tr0fin0/dolphin/README.md

# dolphin
Firmware for `dolphin` board, an ESP32-S3 based sumo robot controller.
