tr0fin0/dolphin/docs/source/hardware/index.rst

Hardware
========

.. toctree::
    :maxdepth: 2
    :caption: Table of Contents

    architecture/index
    encoder/index
    line/index
    mainboard/index
