tr0fin0/dolphin/docs/source/hardware/encoder/files/index.rst

Files
=====

.. toctree::
    :maxdepth: 2
    :caption: Table of Contents

    bom/index
    pcb/index
    sch/index
