tr0fin0/dolphin/docs/source/hardware/encoder/files/pcb/index.rst

PCB
===

.. tab-set::

    .. tab-item:: Bottom

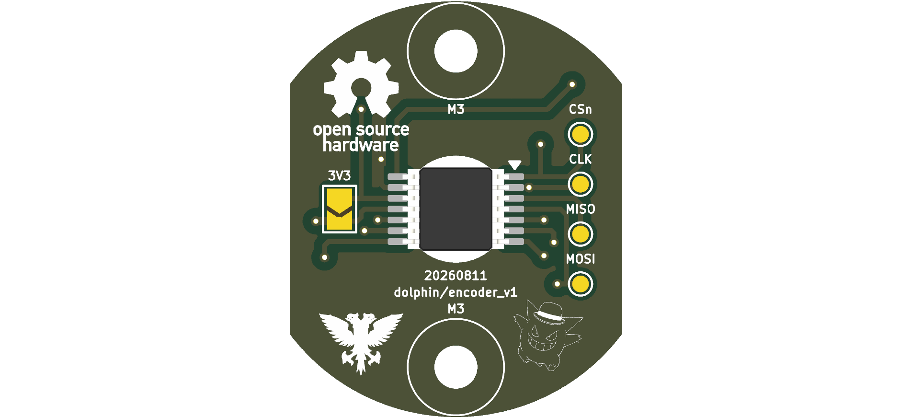
[picture p1: hardware/projects/encoder/images/encoder_bottom.png]
PCB Bottom View
        

    .. tab-item:: Top

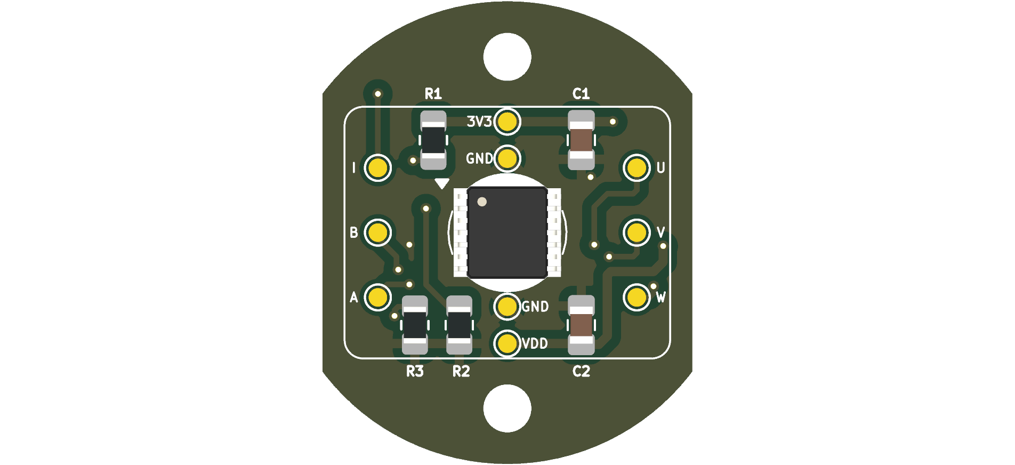
[picture p2: hardware/projects/encoder/images/encoder_top.png]
PCB Top View
