tr0fin0/dolphin/docs/source/hardware/encoder/files/sch/index.rst

SCH
===

.. pdf-include:: ../../../../../../../hardware/projects/encoder/encoder.pdf
