tr0fin0/dolphin/docs/source/hardware/line/files/pcb/index.rst

PCB
===

.. tab-set::

    .. tab-item:: Bottom

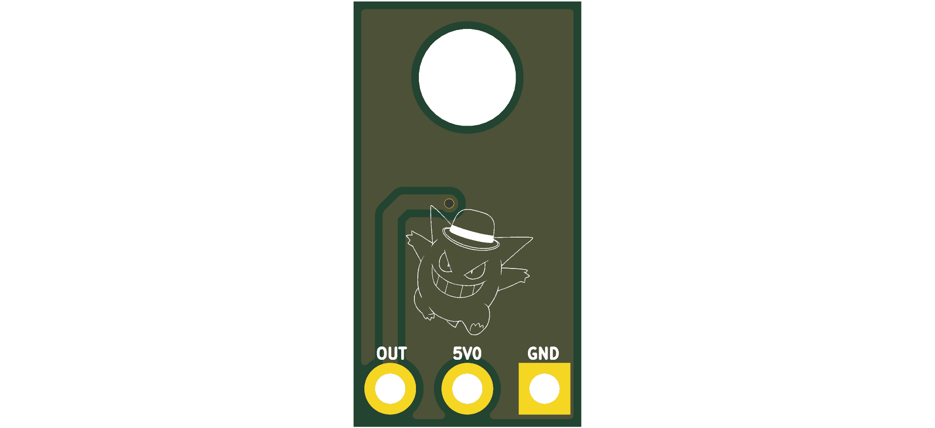
[picture p3: hardware/projects/line/images/line_bottom.png]
PCB Bottom View
        

    .. tab-item:: Top

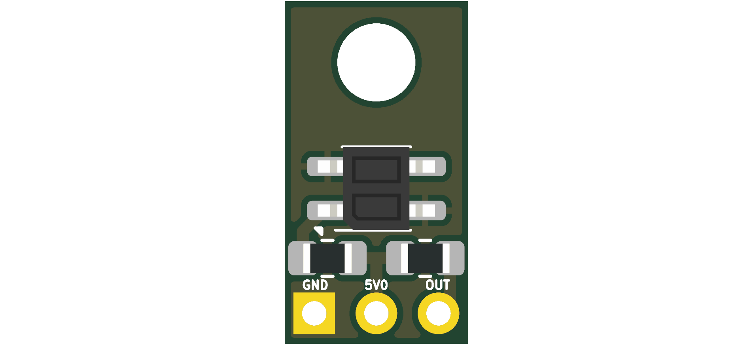
[picture p4: hardware/projects/line/images/line_top.png]
PCB Top View
