tr0fin0/dolphin/docs/source/hardware/mainboard/files/pcb/index.rst

PCB
===

.. tab-set::

    .. tab-item:: Bottom

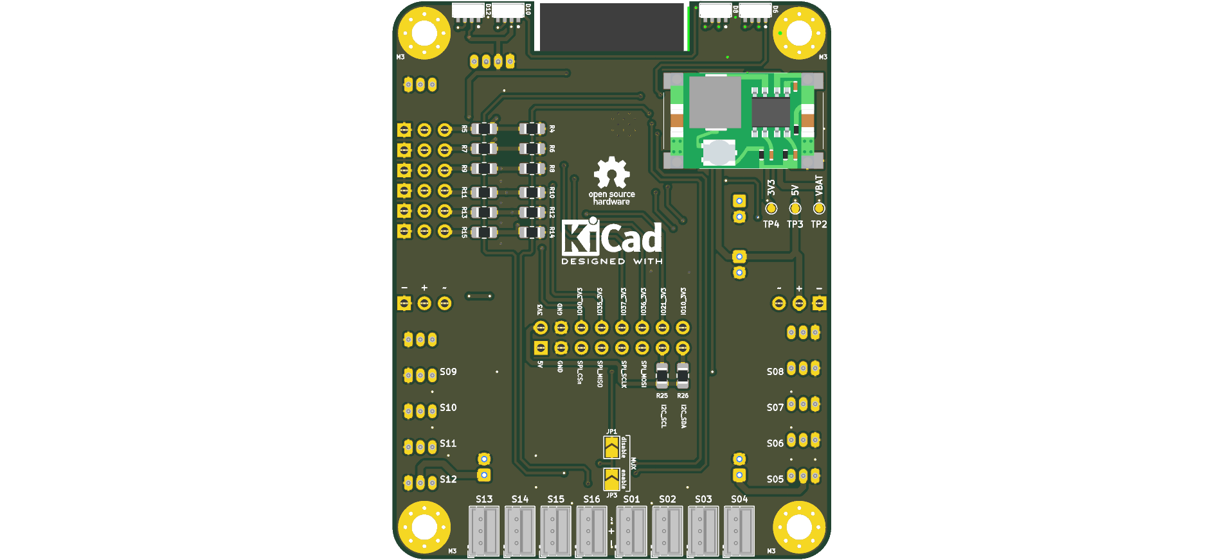
[picture p5: hardware/projects/mainboard/images/mainboard_bottom.png]
PCB Bottom View
        

    .. tab-item:: Top

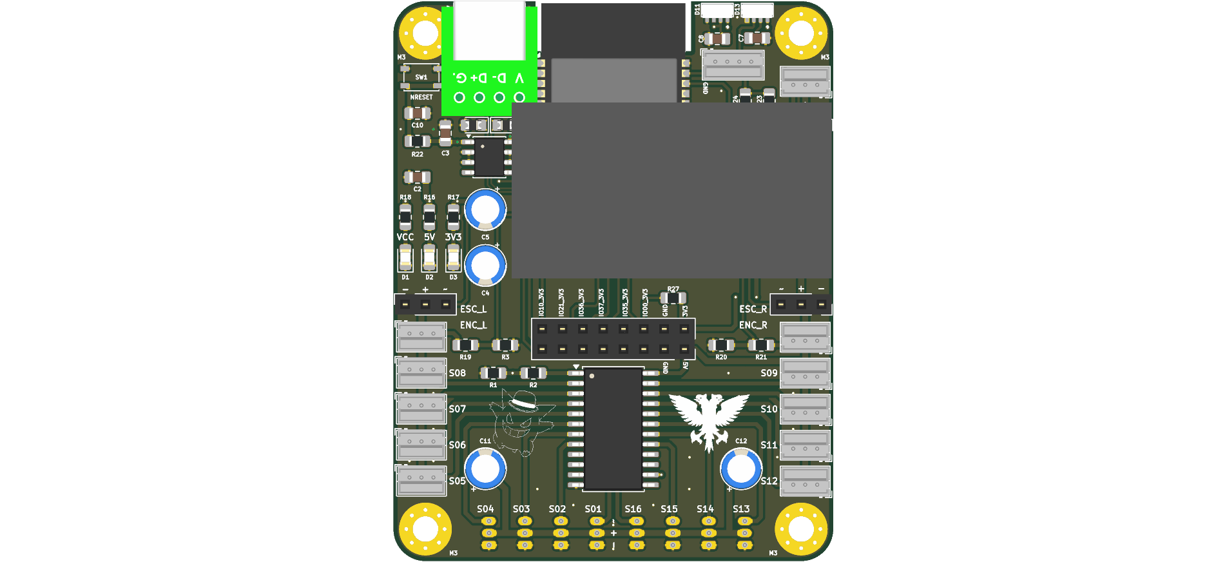
[picture p6: hardware/projects/mainboard/images/mainboard_top.png]
PCB Top View
