tr0fin0/dolphin/docs/source/hardware/encoder/files/bom/index.rst

BOM
===

.. csv-table::
    :file: ../../../../../../hardware/projects/encoder/encoder.csv
    :header-rows: 1
