tr0fin0/dolphin/docs/source/hardware/line/files/bom/index.rst

BOM
===

.. csv-table::
    :file: ../../../../../../hardware/projects/line/line.csv
    :header-rows: 1
