tr0fin0/dolphin/docs/source/hardware/mainboard/files/bom/index.rst

BOM
===

.. csv-table::
    :file: ../../../../../../hardware/projects/mainboard/mainboard.csv
    :header-rows: 1
