tr0fin0/dolphin/hardware/projects/mainboard/mainboard.step

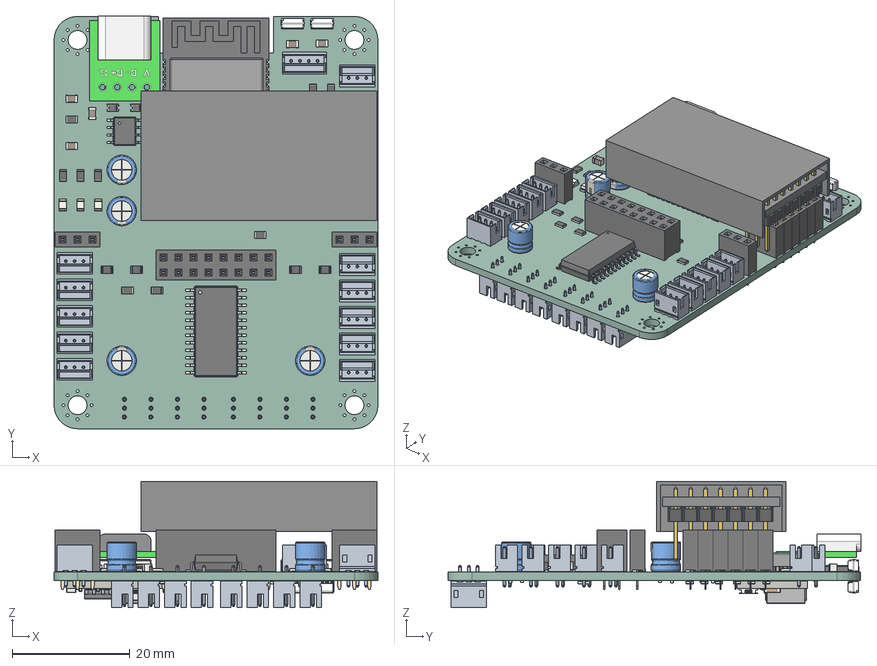
[picture p7: CAD file, 2026-08-26]
hardware/projects/mainboard/mainboard.step
55.0 x 70.0 x 21.5 mm
R_0805_2012Metric x 27
WS2812B-4020 x 8
x1502wv-04k-n0sn
D_0805 x 2
CP_Radial_D50mm_P200mm x 4
C_0805_2012Metric x 8
x1502wv-03k-n0sn x 19
PinSocket_2x08_P254mm_Vertical
LED_0805_2012Metric x 3
SOIC_24W_75x154mm_P127mm
729b06ae-9266-11ed-9e62-a0cec80452fd_part
729b0bae-9266-11ed-9e62-a0cec80452fd_part
729b0e92-9266-11ed-9e62-a0cec80452fd_part
729b1108-9266-11ed-9e62-a0cec80452fd_part
USB-C connector
ESP32-S3-WROOM-1
PinSocket_1x03_P254mm_Vertical x 8
Flysky FS-iA6 Receiver Body
3x7 Header
(Unsaved)
mainboard_PCB
