tr0fin0/dolphin/hardware/projects/encoder/encoder.step

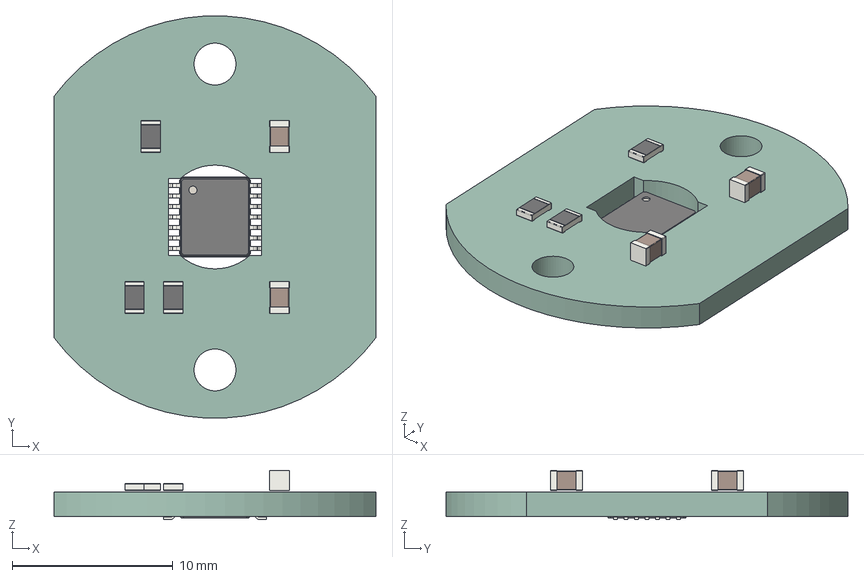
[picture p8: CAD file, 2026-08-26]
hardware/projects/encoder/encoder.step
20.0 x 25.0 x 3.05 mm
C_0805_2012Metric x 2
R_0805_2012Metric x 3
TSSOP_14_44x5mm_P065mm
encoder_PCB
