tr0fin0/dolphin/hardware/projects/line/line.step

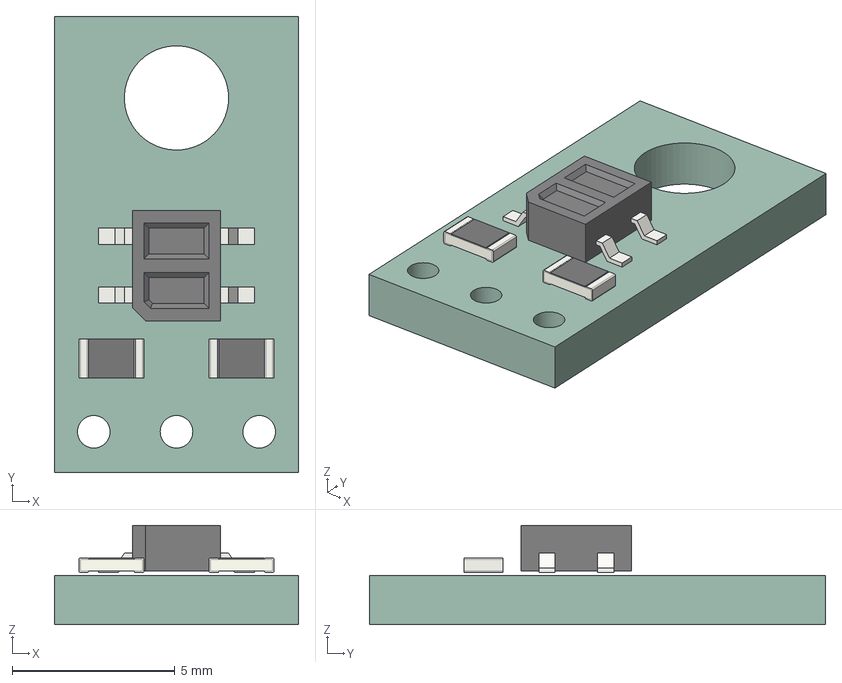
[picture p9: CAD file, 2026-08-26]
hardware/projects/line/line.step
7.50 x 14.0 x 3.04 mm
R_0805_2012Metric x 2
OnSemi_CASE100CY
line_PCB
