tr0fin0/dolphin/docs/source/installation/index.rst

Installation
============

.. toctree::
   :maxdepth: 2
   :caption: Table of Contents

   kicad/index
   platformio/index
