tr0fin0/dolphin/docs/source/installation/kicad/index.rst

KiCAD
=====

After `installing KiCAD <https://www.kicad.org/download/>`_ make sure that the Footprint and Symbol libraries are correctly referenced in the project.

.. toctree::
   :maxdepth: 2
   :caption: Table of Contents

   how-to/index
