tr0fin0/dolphin/docs/source/installation/kicad/how-to/index.rst

How To...
=========

.. toctree::
   :maxdepth: 2

   footprint/index
   symbol/index
