tr0fin0/dolphin/.github/ISSUES_TEMPLATE/bug.md

---
name: bug
about: Issue reporting a code bug.
title: ''
labels: ''
assignees: ''

---

**Description**
A clear and concise description of what the bug is.

**To Reproduce**
Steps to reproduce the behavior:
1.

**Expected Behavior**
A clear and concise description of what you expected to happen.

**Platform**
 - OS: [e.g. Ubuntu 24.04 LTS]
 - IDE: [e.g. VSCode]
 - TeX Live version: [e.g. 2025]

**Additional Information**
Add any other context about the problem.
