tr0fin0/dolphin/hardware/projects/encoder/encoder.pdf

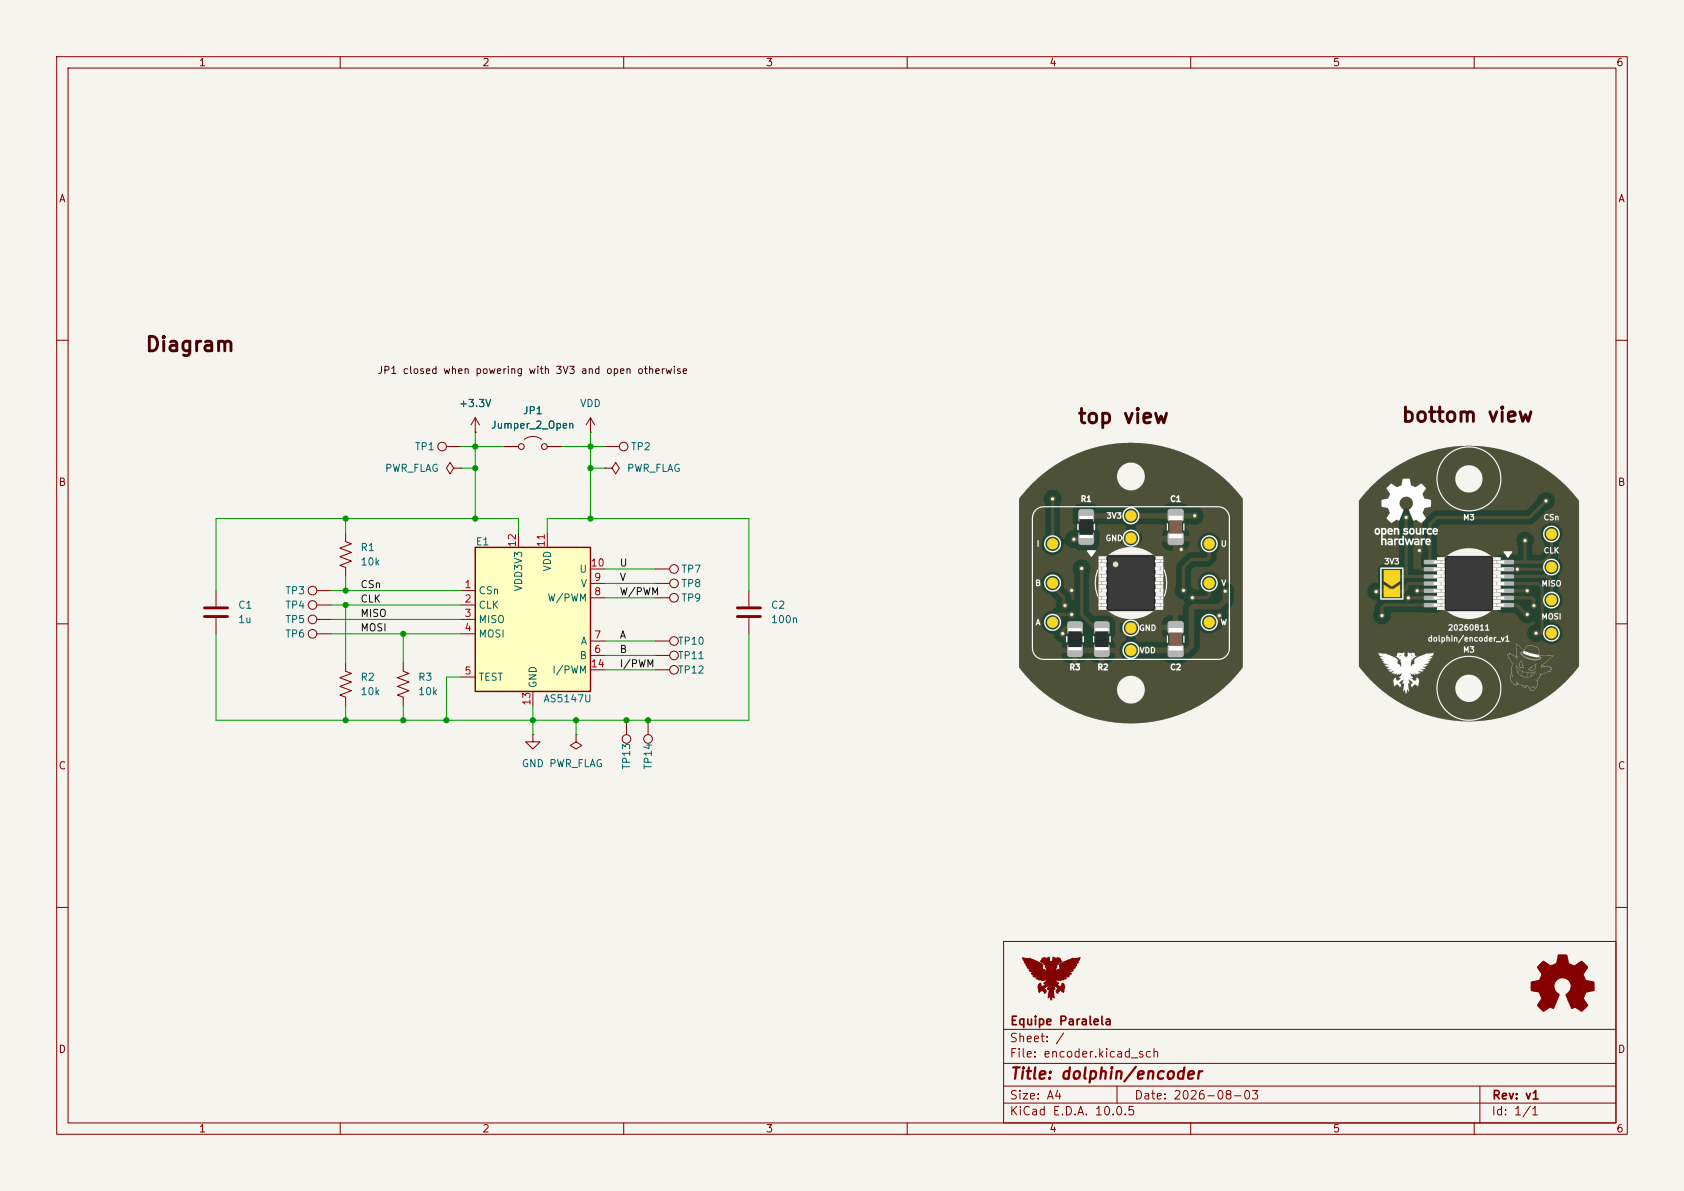
[picture p10: page 1]

JP1 closed when powering with 3V3 and open otherwise Diagram

Size: A4 | Rev: v1
KiCad E.D.A. 10.0.5 | Id: 1/1
