tr0fin0/dolphin/hardware/projects/line/line.pdf

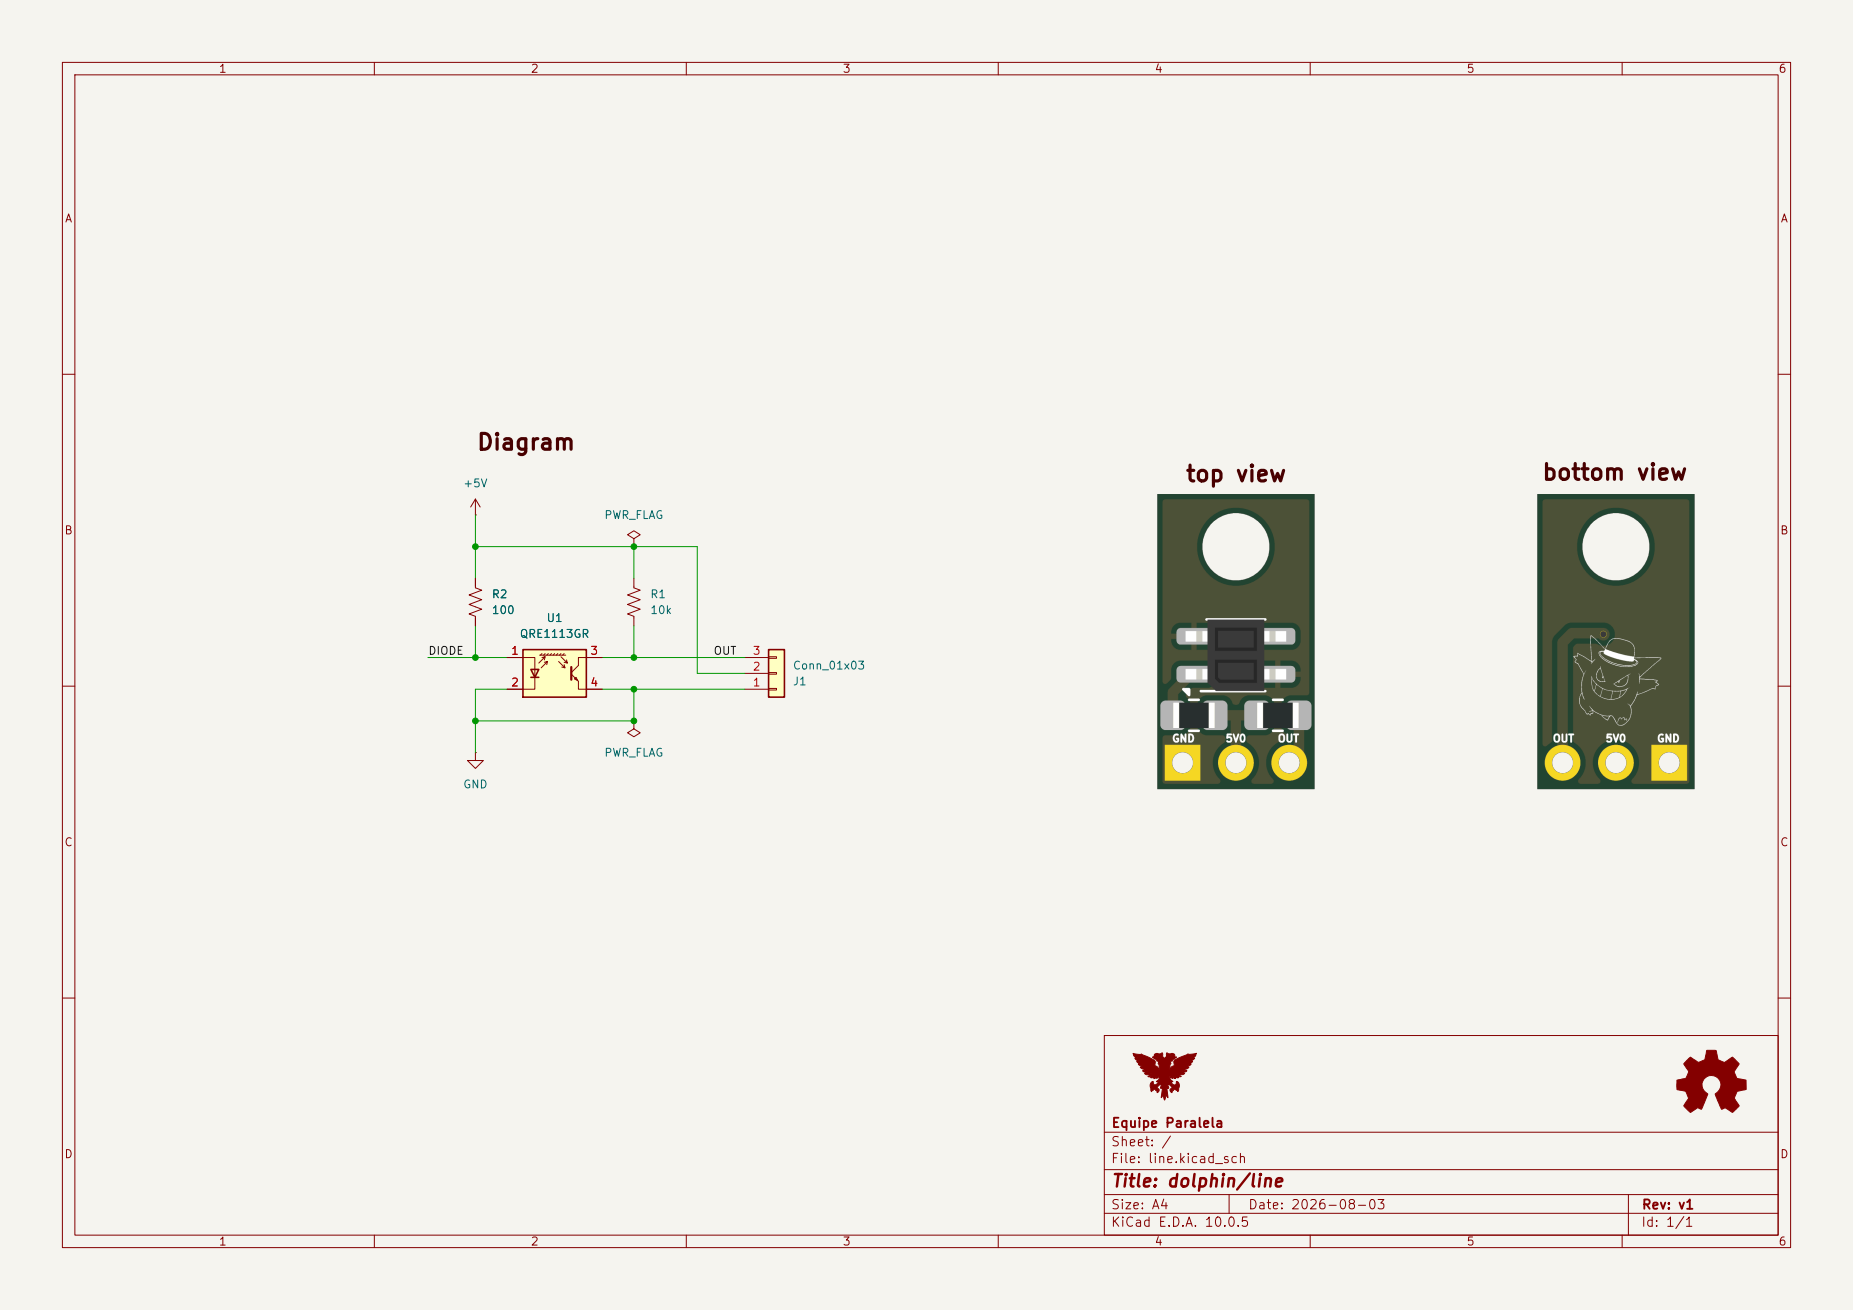
[picture p11: page 1]

Size: A4 | Rev: v1
KiCad E.D.A. 10.0.5 | Id: 1/1
