tr0fin0/dolphin/hardware/projects/mainboard/mainboard.pdf

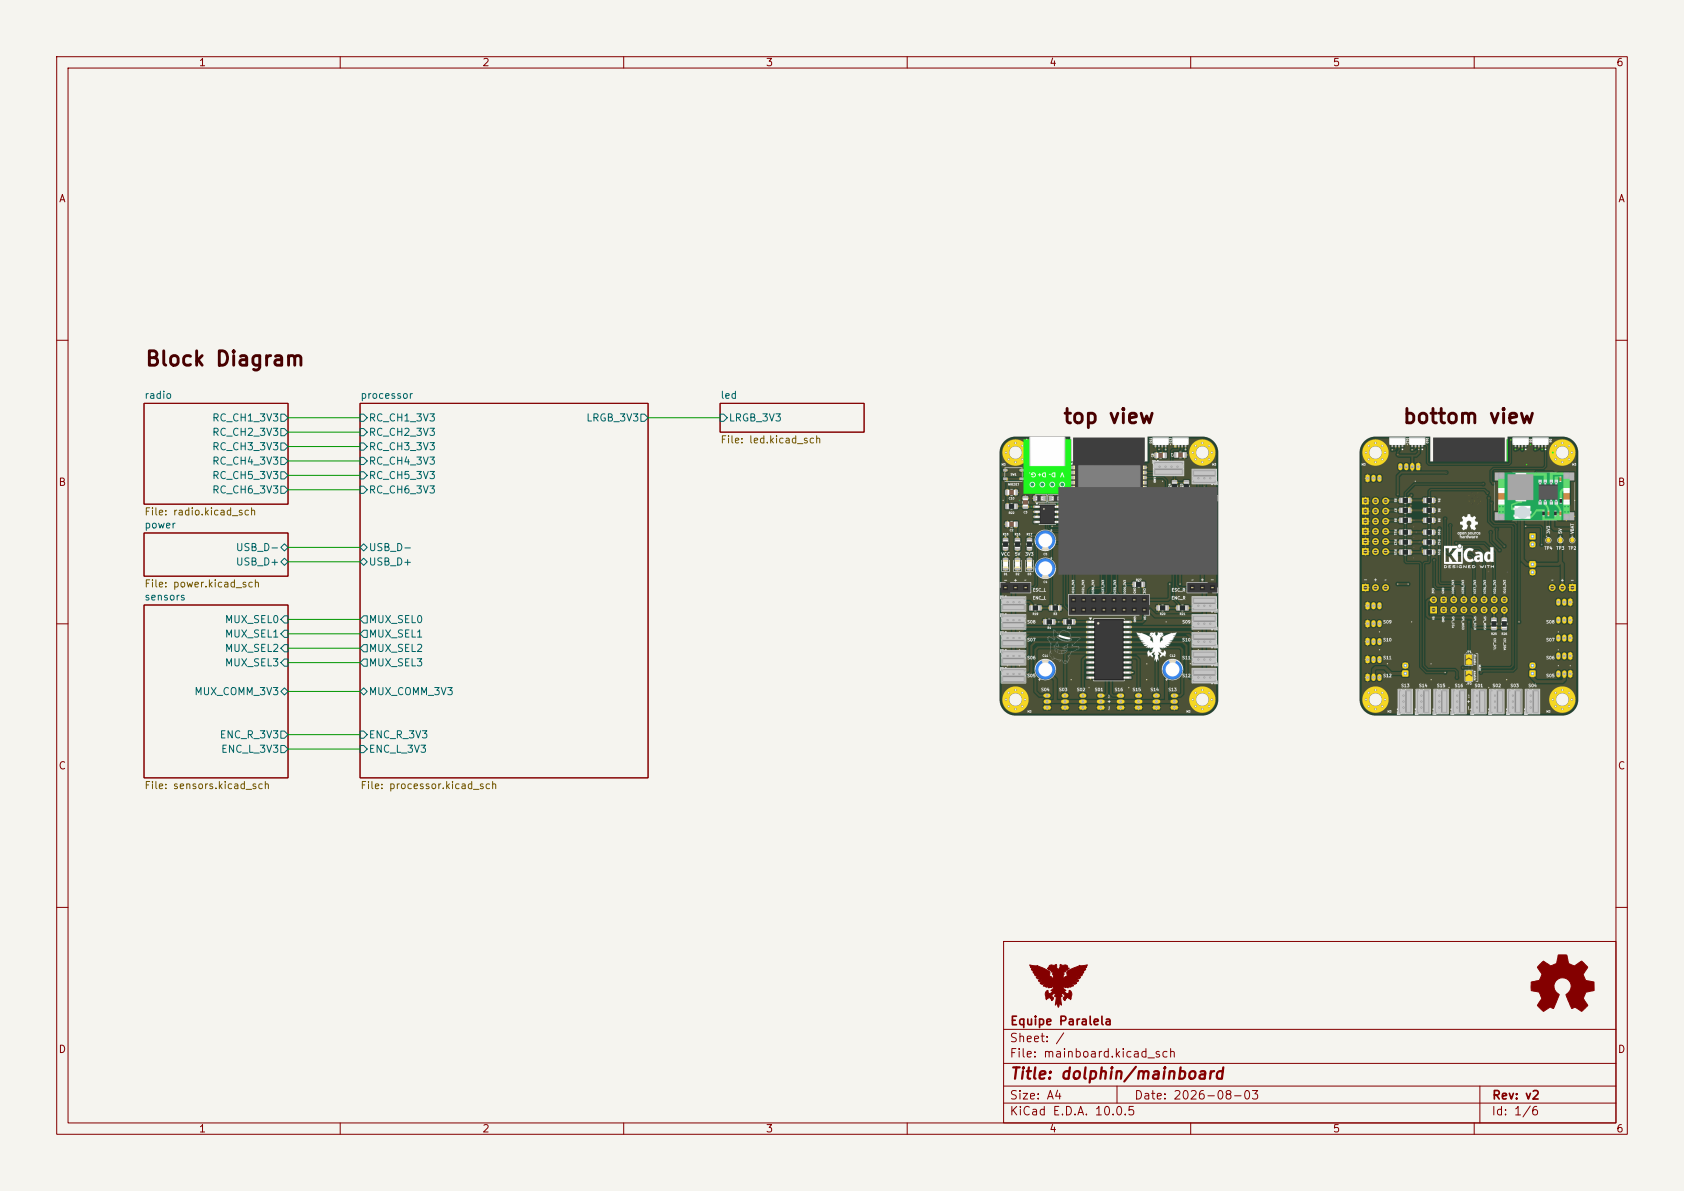
[picture p12: page 1]

Size: A4 | Rev: v2
KiCad E.D.A. 10.0.5 | Id: 1/6

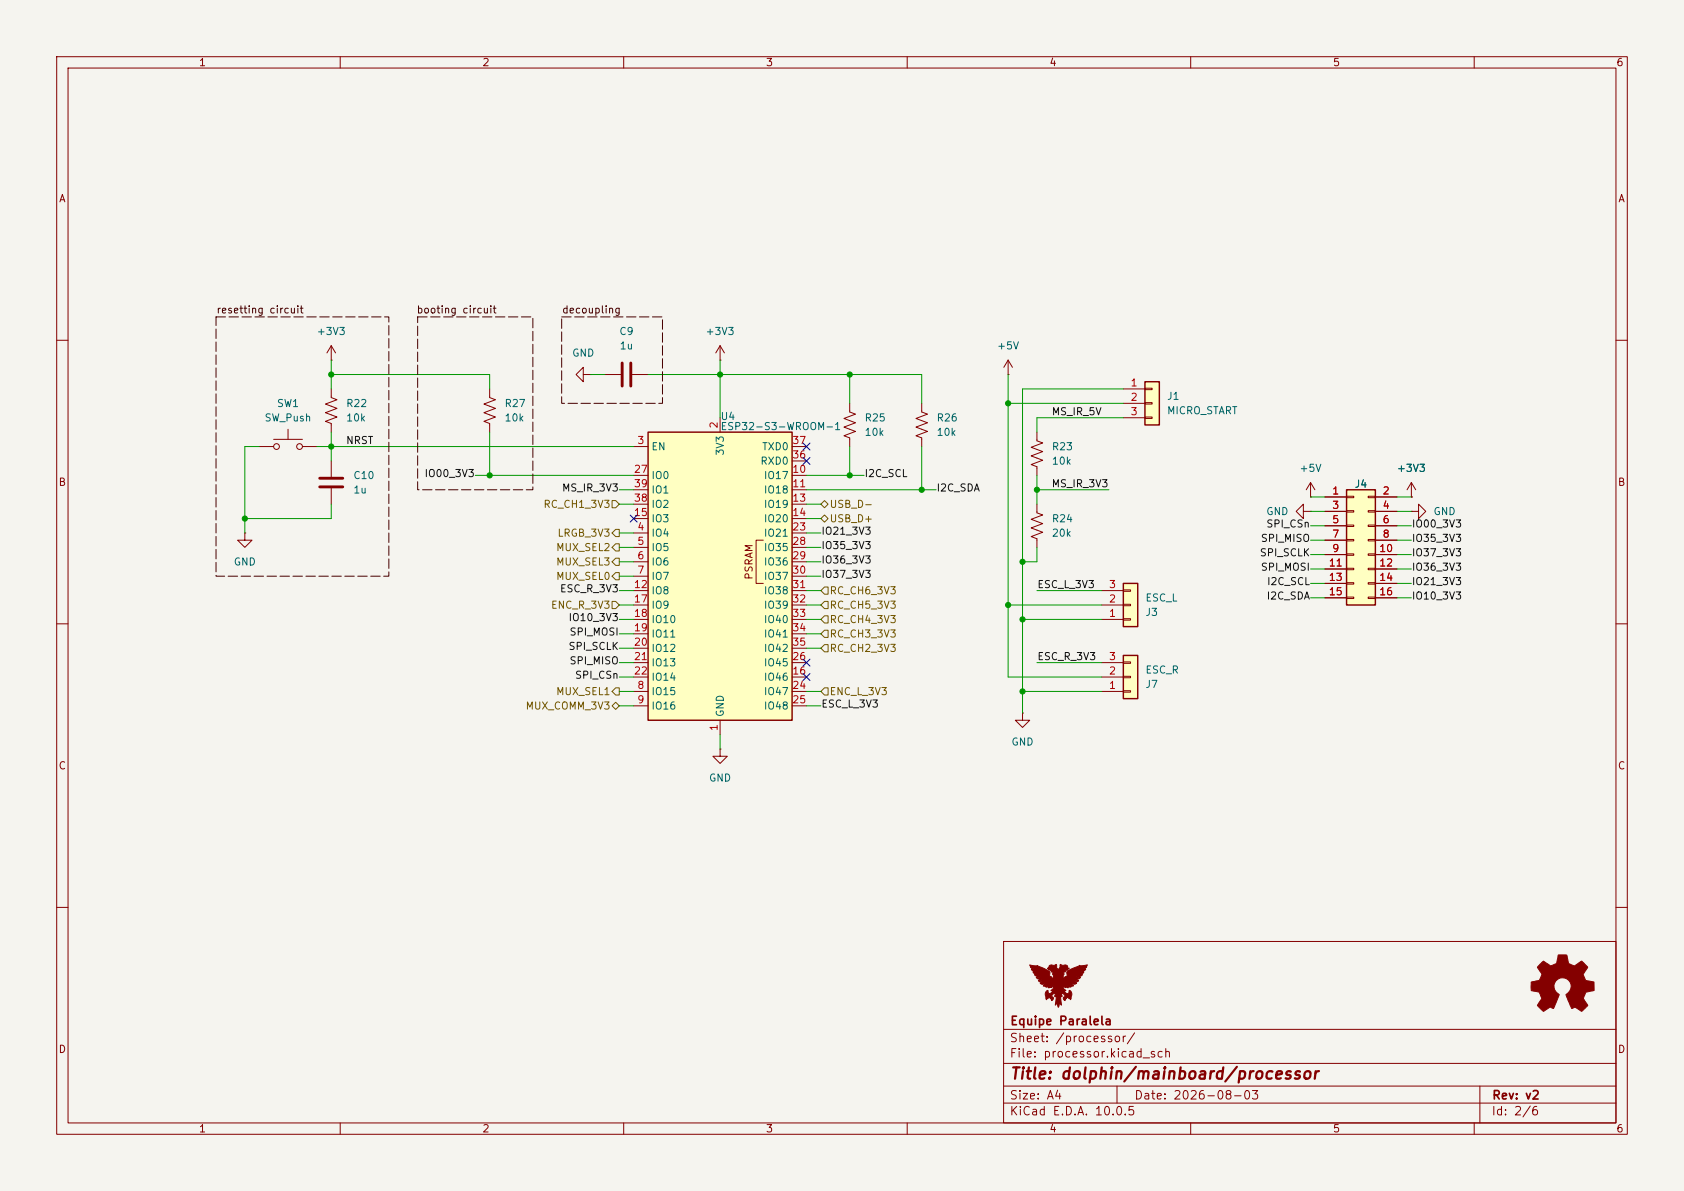
[picture p13: page 2]

Equipe Paralela
Sheet: /processor/
File: processor.kicad_sch
Title: dolphin/mainboard/processor

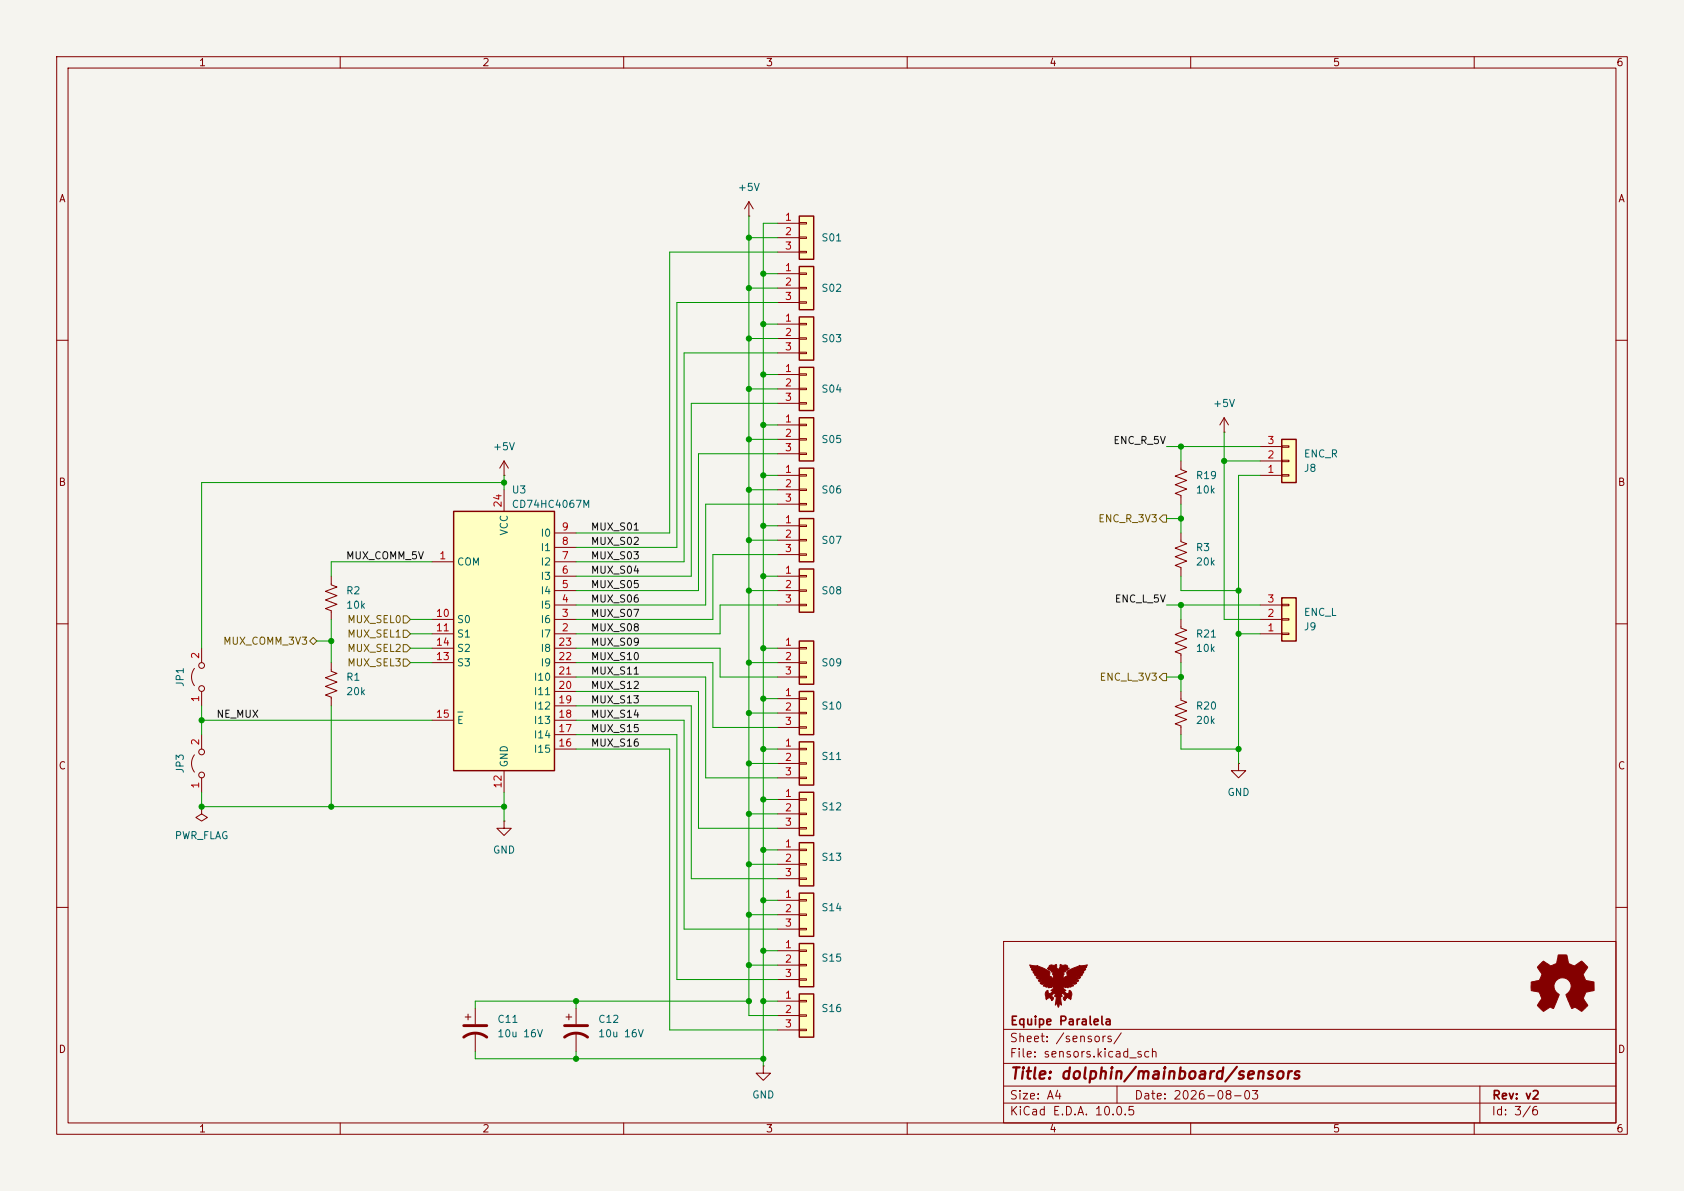
[picture p14: page 3]

Equipe Paralela
Sheet: /sensors/
File: sensors.kicad_sch
Title: dolphin/mainboard/sensors

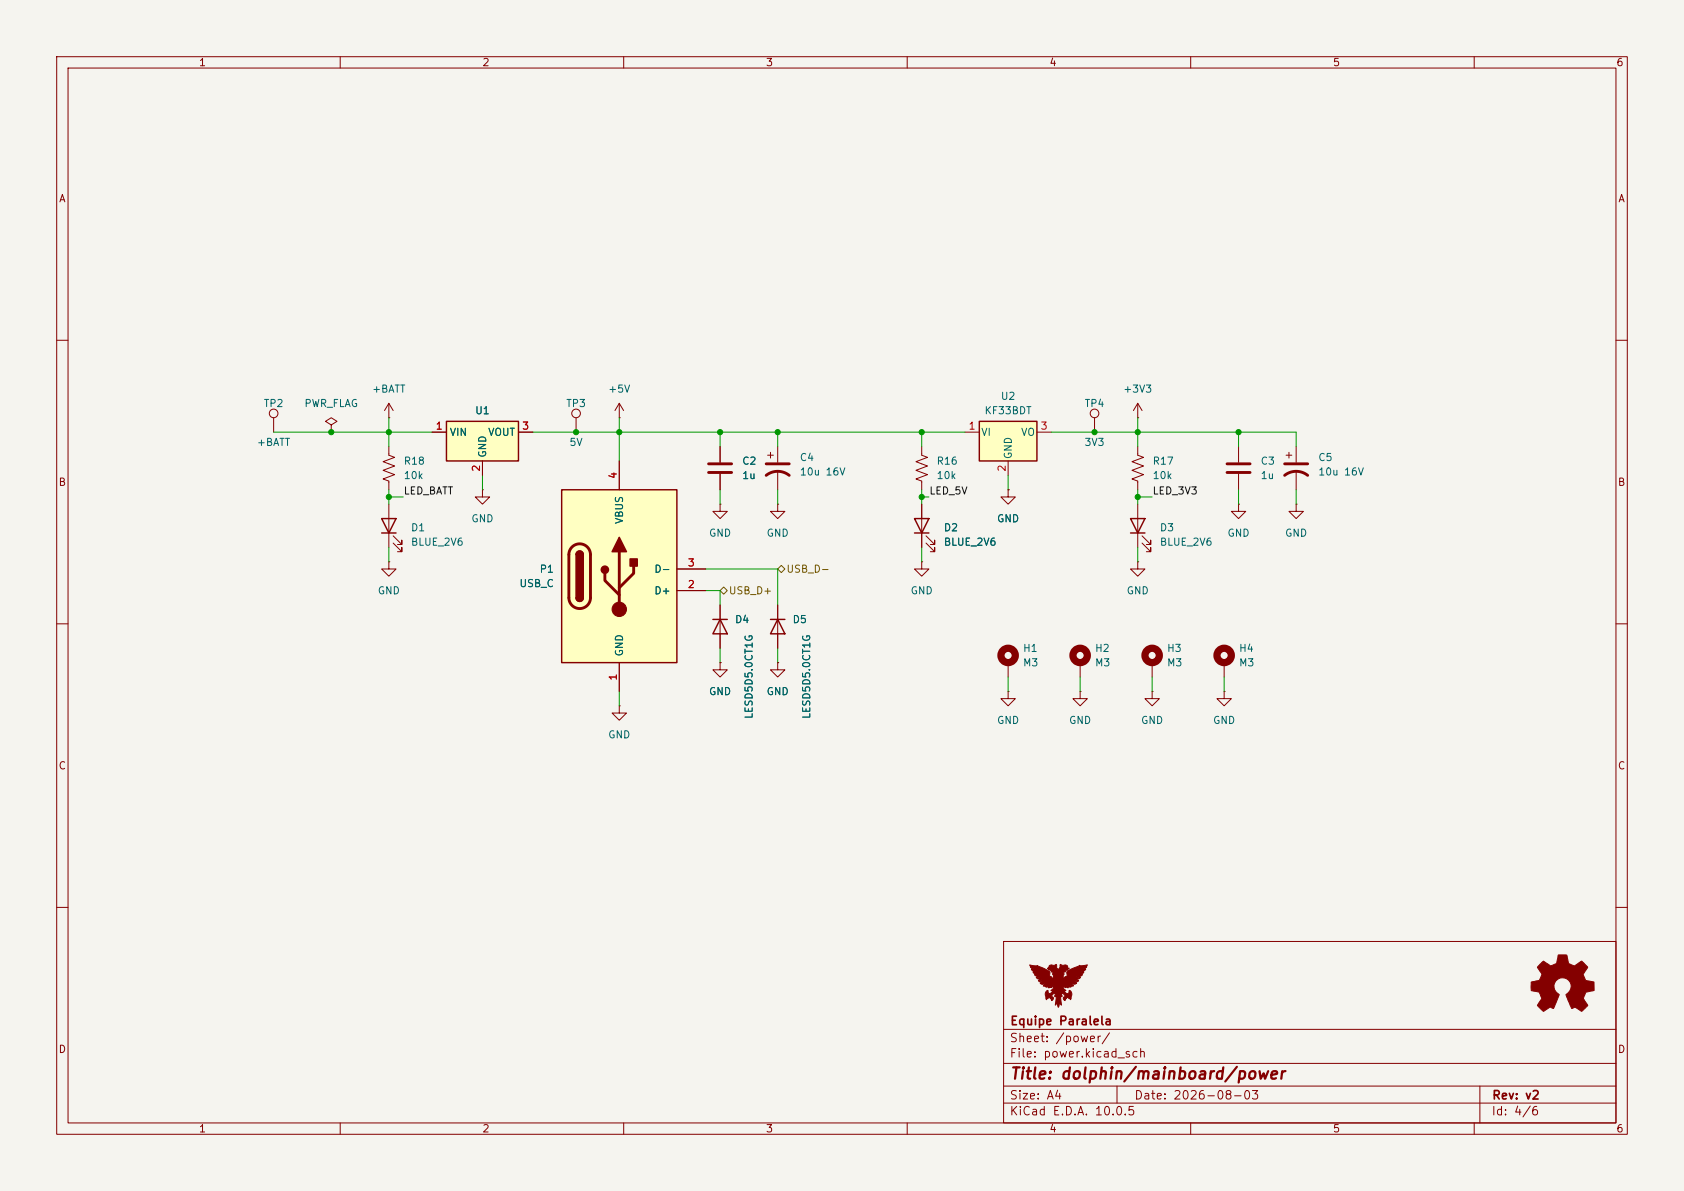
[picture p15: page 4]

Equipe Paralela
Sheet: /power/
File: power.kicad_sch
Title: dolphin/mainboard/power

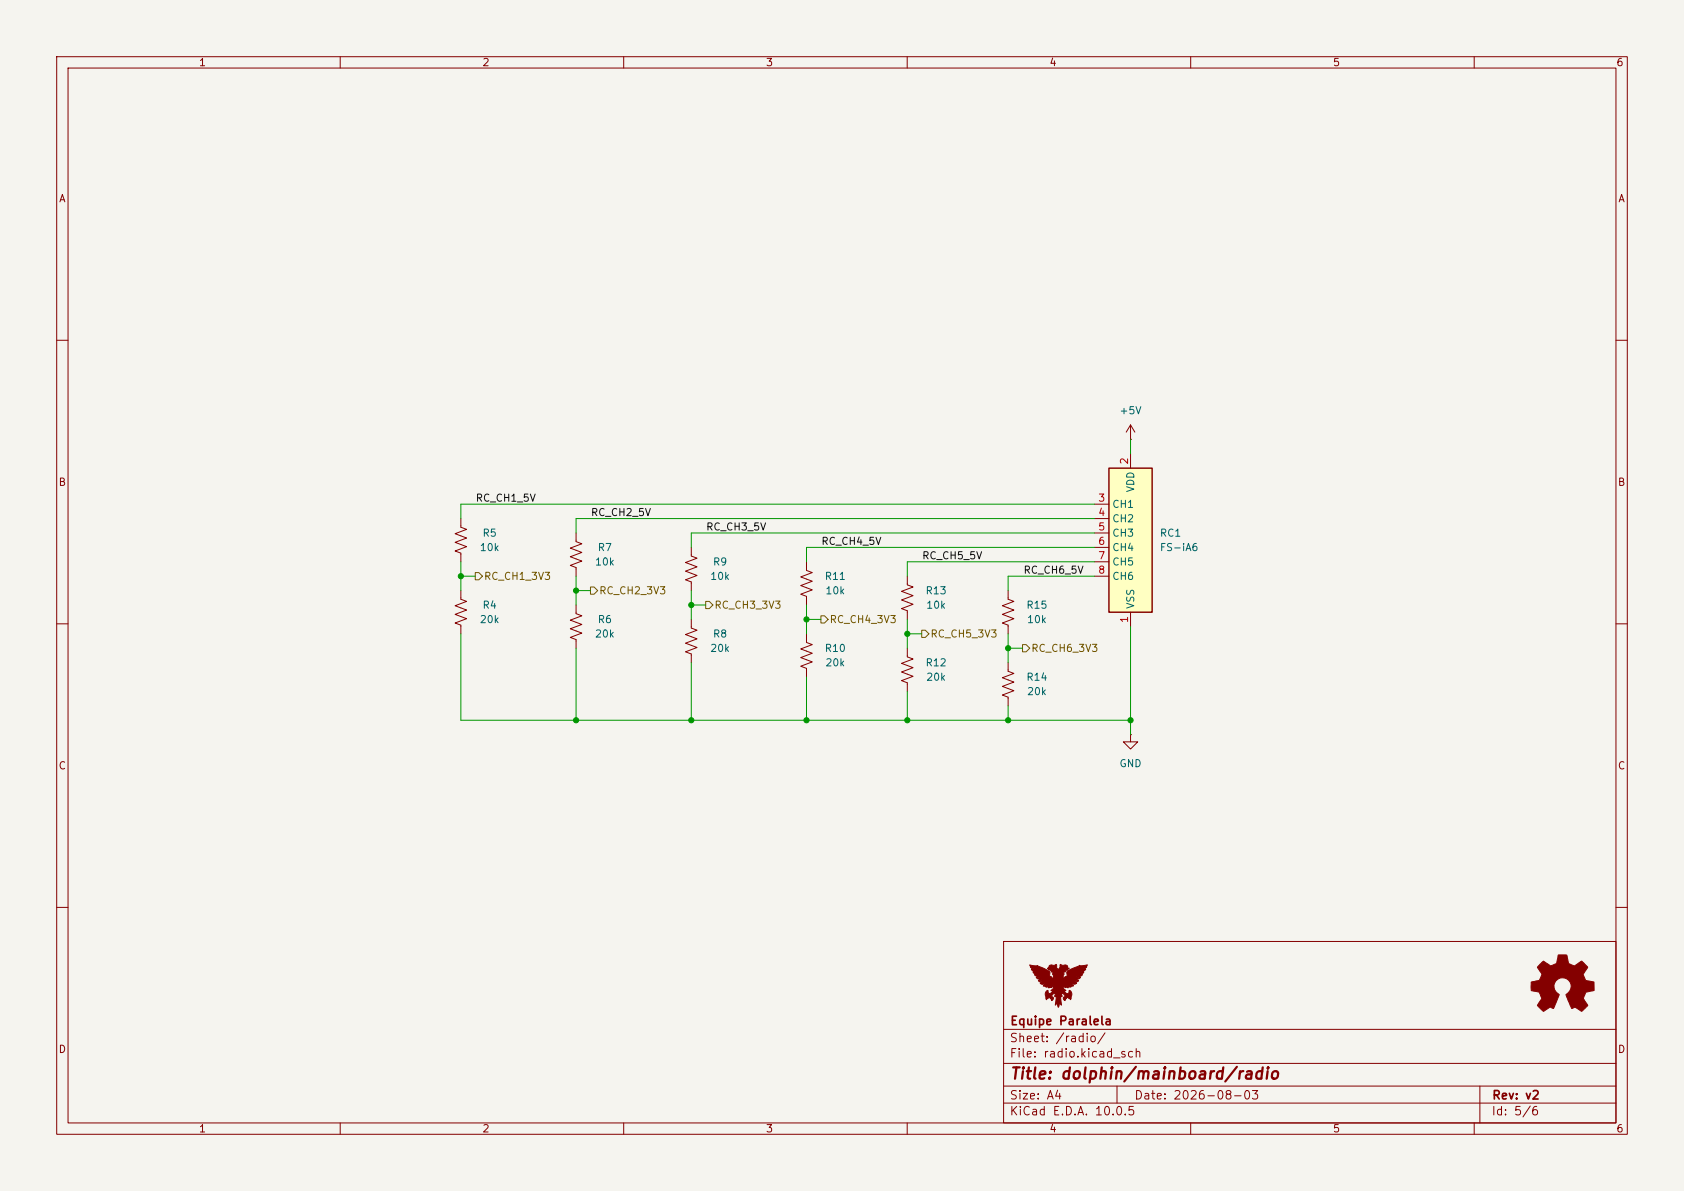
[picture p16: page 5]

Equipe Paralela
Sheet: /radio/
File: radio.kicad_sch
Title: dolphin/mainboard/radio

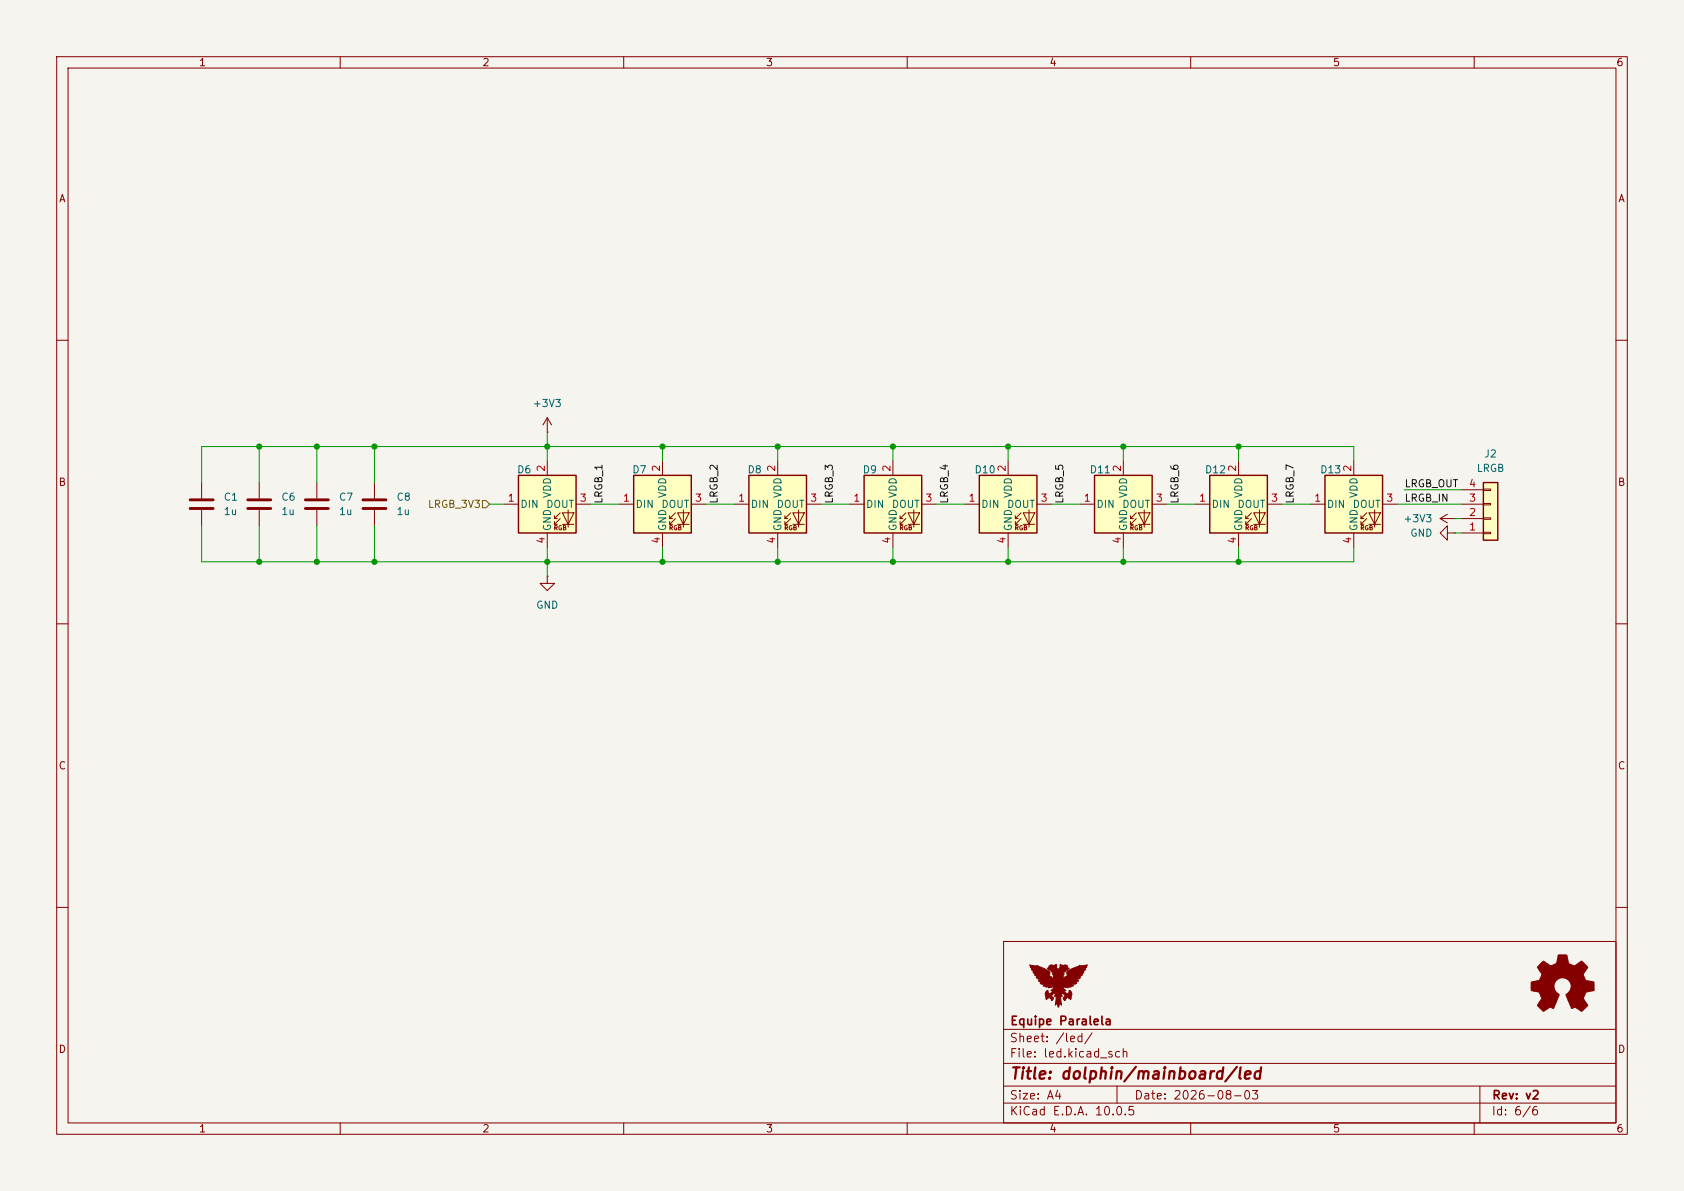
[picture p17: page 6]

Equipe Paralela
Sheet: /led/
File: led.kicad_sch
Title: dolphin/mainboard/led
