tr0fin0/dolphin/hardware/projects/mainboard/mainboard.kicad_pcb

## KiCad design hardware/projects/mainboard/mainboard.kicad_pcb (2026-08-26)

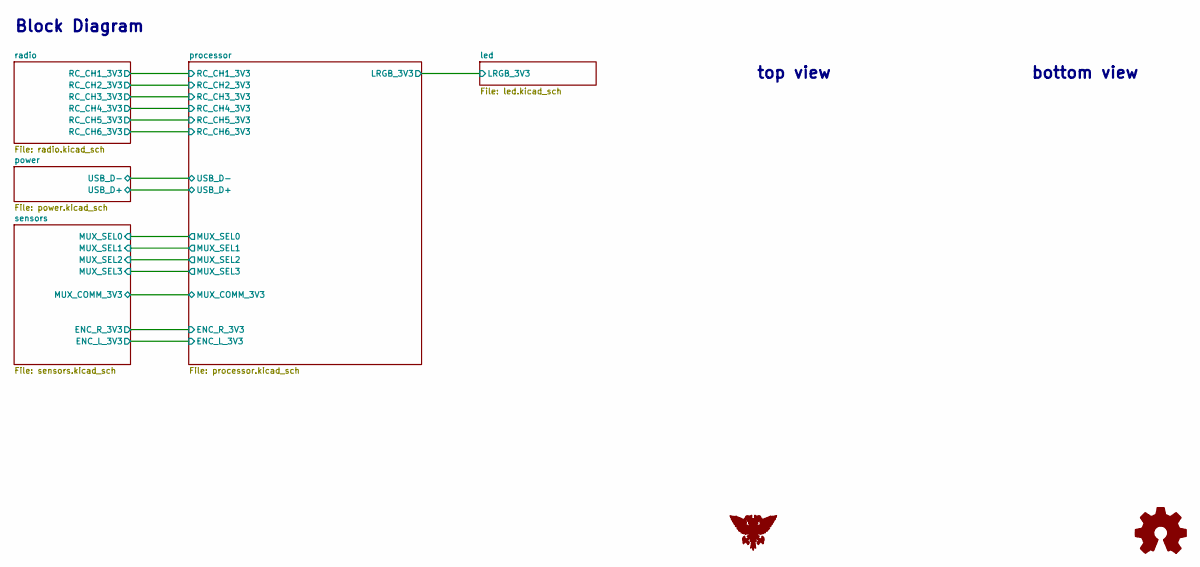
[picture p18: schematic mainboard.kicad_sch]

Notes on the sheet:
top view
bottom view
Block Diagram

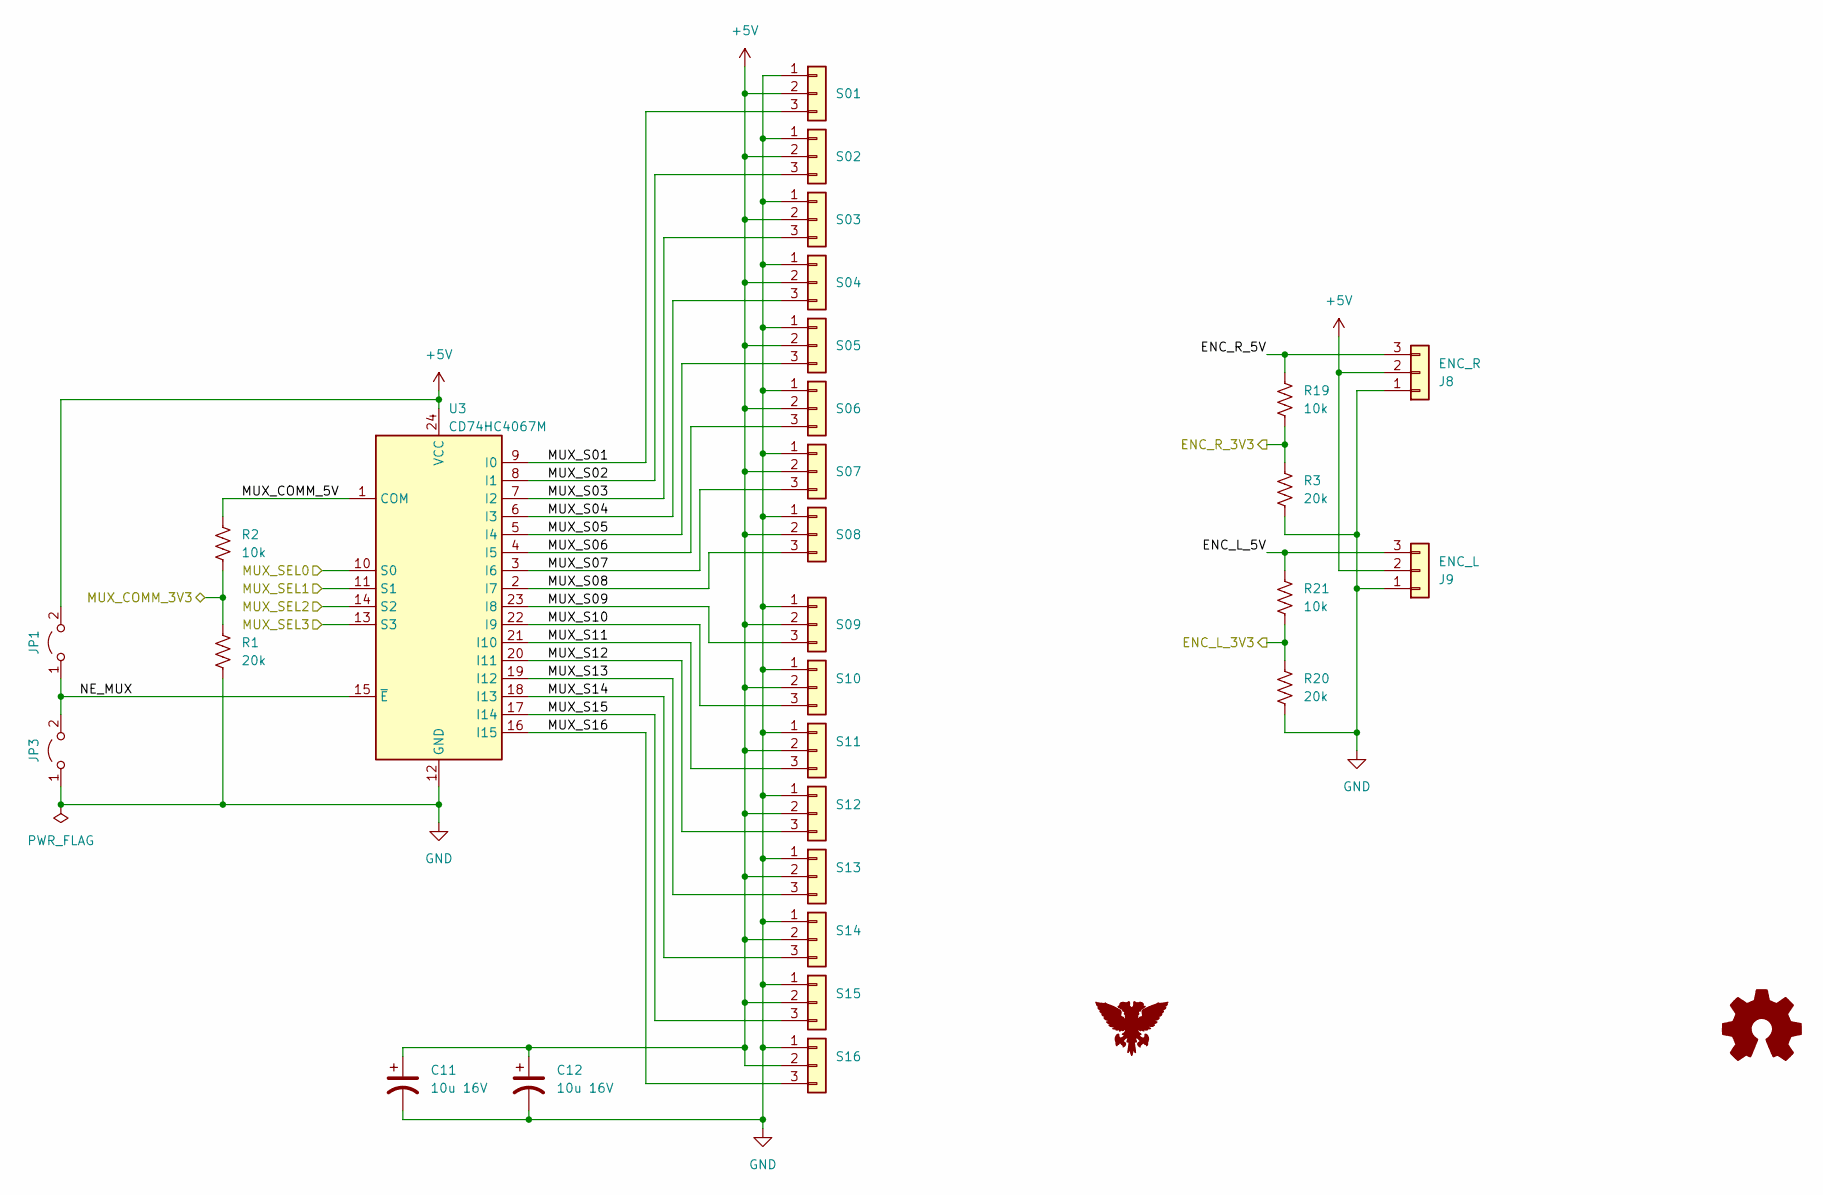
[picture p19: schematic sensors.kicad_sch]

Parts:
C11, C12: 10u 16V; CP_Radial_D5.0mm_P2.00mm
J8: ENC_R; Connector_JST_ZH_B3B-ZR_1x03_P1.50mm_Vertical
J9: ENC_L; Connector_JST_ZH_B3B-ZR_1x03_P1.50mm_Vertical
JP1, JP3: Jumper_2_Open; SolderJumper-2_P1.3mm_Open_TrianglePad1.0x1.5mm
R1, R3, R20: 20k; R_0805_2012Metric_Pad1.20x1.40mm_HandSolder
R2, R19, R21: 10k; R_0805_2012Metric_Pad1.20x1.40mm_HandSolder
S01, S02, S03, S04, S05, S06, S07, S08, S09, S10, S11, S12, S13, S14, S15, S16: Conn_01x03; Connector_JST_ZH_B3B-ZR_1x03_P1.50mm_Vertical
U3: CD74HC4067M; SOIC-24W_7.5x15.4mm_P1.27mm

Connections:
+5V: C11.1, C12.1, J8.2, J9.2, JP1.2 (B), S01.2, S02.2, S03.2, S04.2, S05.2, S06.2, S07.2, S08.2, S09.2, S10.2, S11.2, S12.2, S13.2, S14.2, S15.2, S16.2, U3.24 (VCC); also elsewhere on the board
/processor/ENC_L_3V3: R20.1, R21.1; also elsewhere on the board
/processor/ENC_R_3V3: R3.1, R19.1; also elsewhere on the board
/processor/MUX_COMM_3V3: R1.1, R2.1; also elsewhere on the board
/processor/MUX_SEL0: U3.10 (S0); also elsewhere on the board
/processor/MUX_SEL1: U3.11 (S1); also elsewhere on the board
/processor/MUX_SEL2: U3.14 (S2); also elsewhere on the board
/processor/MUX_SEL3: U3.13 (S3); also elsewhere on the board
/sensors/ENC_L_5V: J9.3, R21.2
/sensors/ENC_R_5V: J8.3, R19.2
/sensors/MUX_COMM_5V: R2.2, U3.1 (COM)
/sensors/MUX_S01: S01.3, U3.9 (I0)
/sensors/MUX_S02: S02.3, U3.8 (I1)
/sensors/MUX_S03: S03.3, U3.7 (I2)
/sensors/MUX_S04: S04.3, U3.6 (I3)
/sensors/MUX_S05: S05.3, U3.5 (I4)
/sensors/MUX_S06: S06.3, U3.4 (I5)
/sensors/MUX_S07: S07.3, U3.3 (I6)
/sensors/MUX_S08: S08.3, U3.2 (I7)
/sensors/MUX_S09: S09.3, U3.23 (I8)
/sensors/MUX_S10: S10.3, U3.22 (I9)
/sensors/MUX_S11: S11.3, U3.21 (I10)
/sensors/MUX_S12: S12.3, U3.20 (I11)
/sensors/MUX_S13: S13.3, U3.19 (I12)
/sensors/MUX_S14: S14.3, U3.18 (I13)
/sensors/MUX_S15: S15.3, U3.17 (I14)
/sensors/MUX_S16: S16.3, U3.16 (I15)
/sensors/NE_MUX: JP1.1 (A), JP3.2 (B), U3.15 (~E)
GND: C11.2, C12.2, J8.1, J9.1, JP3.1 (A), R1.2, R3.2, R20.2, S01.1, S02.1, S03.1, S04.1, S05.1, S06.1, S07.1, S08.1, S09.1, S10.1, S11.1, S12.1, S13.1, S14.1, S15.1, S16.1, U3.12 (GND); also elsewhere on the board

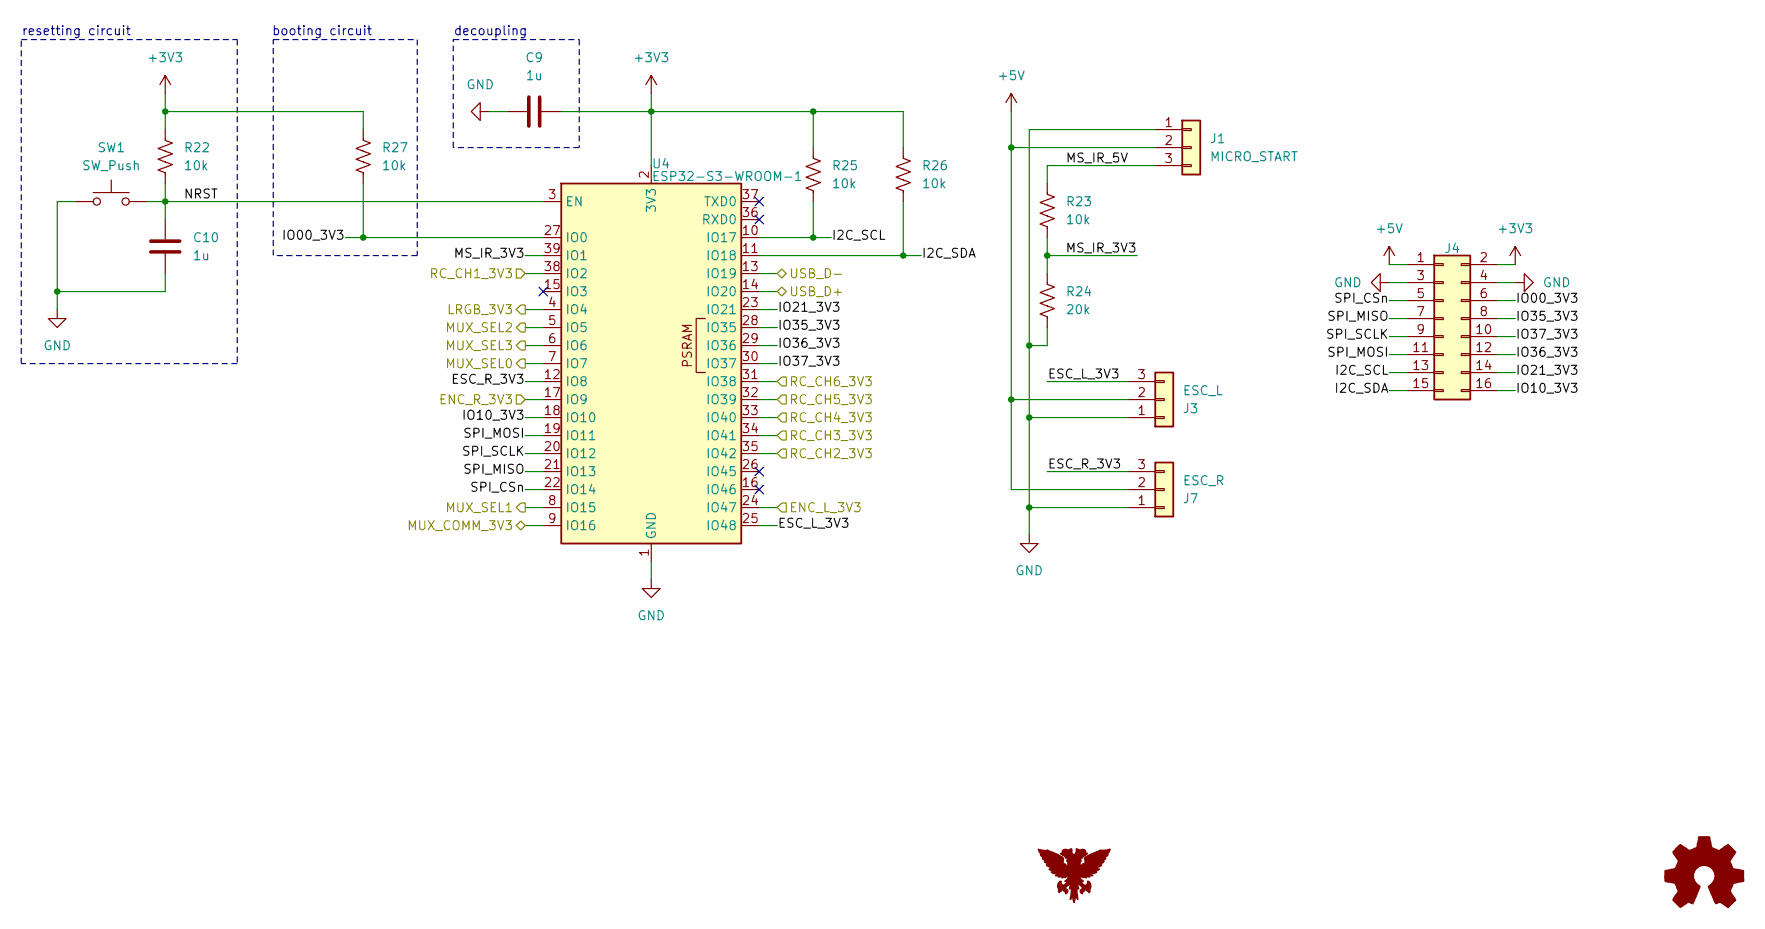
[picture p20: schematic processor.kicad_sch]

Parts:
C9, C10: 1u; C_0805_2012Metric_Pad1.18x1.45mm_HandSolder
J1: MICRO_START; Connector_JST_ZH_B3B-ZR_1x03_P1.50mm_Vertical
J3: ESC_L; PinSocket_1x03_P2.54mm_Vertical
J4: Conn_02x08_Odd_Even; PinSocket_2x08_P2.54mm_Vertical
J7: ESC_R; PinSocket_1x03_P2.54mm_Vertical
R22, R23, R25, R26, R27: 10k; R_0805_2012Metric_Pad1.20x1.40mm_HandSolder
R24: 20k; R_0805_2012Metric_Pad1.20x1.40mm_HandSolder
SW1: SW_Push; SW_SPST_PTS810
U4: ESP32-S3-WROOM-1

Connections:
+3V3: C9.2, J4.2, R22.1, R25.1, R26.1, R27.2, U4.2 (3V3); also elsewhere on the board
+5V: J1.2, J3.2, J4.1, J7.2; also elsewhere on the board
/led/LRGB_3V3: U4.4 (IO4); also elsewhere on the board
/power/USB_D+: U4.14 (IO20); also elsewhere on the board
/power/USB_D-: U4.13 (IO19); also elsewhere on the board
/processor/ENC_L_3V3: U4.24 (IO47); also elsewhere on the board
/processor/ENC_R_3V3: U4.17 (IO9); also elsewhere on the board
/processor/ESC_L_3V3: J3.3, U4.25 (IO48)
/processor/ESC_R_3V3: J7.3, U4.12 (IO8)
/processor/I2C_SCL: J4.13, R25.2, U4.10 (IO17)
/processor/I2C_SDA: J4.15, R26.2, U4.11 (IO18)
/processor/IO00_3V3: J4.6, R27.1, U4.27 (IO0)
/processor/IO10_3V3: J4.16, U4.18 (IO10)
/processor/IO21_3V3: J4.14, U4.23 (IO21)
/processor/IO35_3V3: J4.8, U4.28 (IO35)
/processor/IO36_3V3: J4.12, U4.29 (IO36)
/processor/IO37_3V3: J4.10, U4.30 (IO37)
/processor/MS_IR_3V3: R23.2, R24.1, U4.39 (IO1)
/processor/MS_IR_5V: J1.3, R23.1
/processor/MUX_COMM_3V3: U4.9 (IO16); also elsewhere on the board
/processor/MUX_SEL0: U4.7 (IO7); also elsewhere on the board
/processor/MUX_SEL1: U4.8 (IO15); also elsewhere on the board
/processor/MUX_SEL2: U4.5 (IO5); also elsewhere on the board
/processor/MUX_SEL3: U4.6 (IO6); also elsewhere on the board
/processor/NRST: C10.1, R22.2, SW1.2, U4.3 (EN)
/processor/RC_CH1_3V3: U4.38 (IO2); also elsewhere on the board
/processor/RC_CH2_3V3: U4.35 (IO42); also elsewhere on the board
/processor/RC_CH3_3V3: U4.34 (IO41); also elsewhere on the board
/processor/RC_CH4_3V3: U4.33 (IO40); also elsewhere on the board
/processor/RC_CH5_3V3: U4.32 (IO39); also elsewhere on the board
/processor/RC_CH6_3V3: U4.31 (IO38); also elsewhere on the board
/processor/SPI_CSn: J4.5, U4.22 (IO14)
/processor/SPI_MISO: J4.7, U4.21 (IO13)
/processor/SPI_MOSI: J4.11, U4.19 (IO11)
/processor/SPI_SCLK: J4.9, U4.20 (IO12)
GND: C9.1, C10.2, J1.1, J3.1, J4.3, J4.4, J7.1, R24.2, SW1.1, U4.1 (GND), U4.40 (GND), U4.41 (GND); also elsewhere on the board

Notes on the sheet:
resetting circuit
decoupling
booting circuit

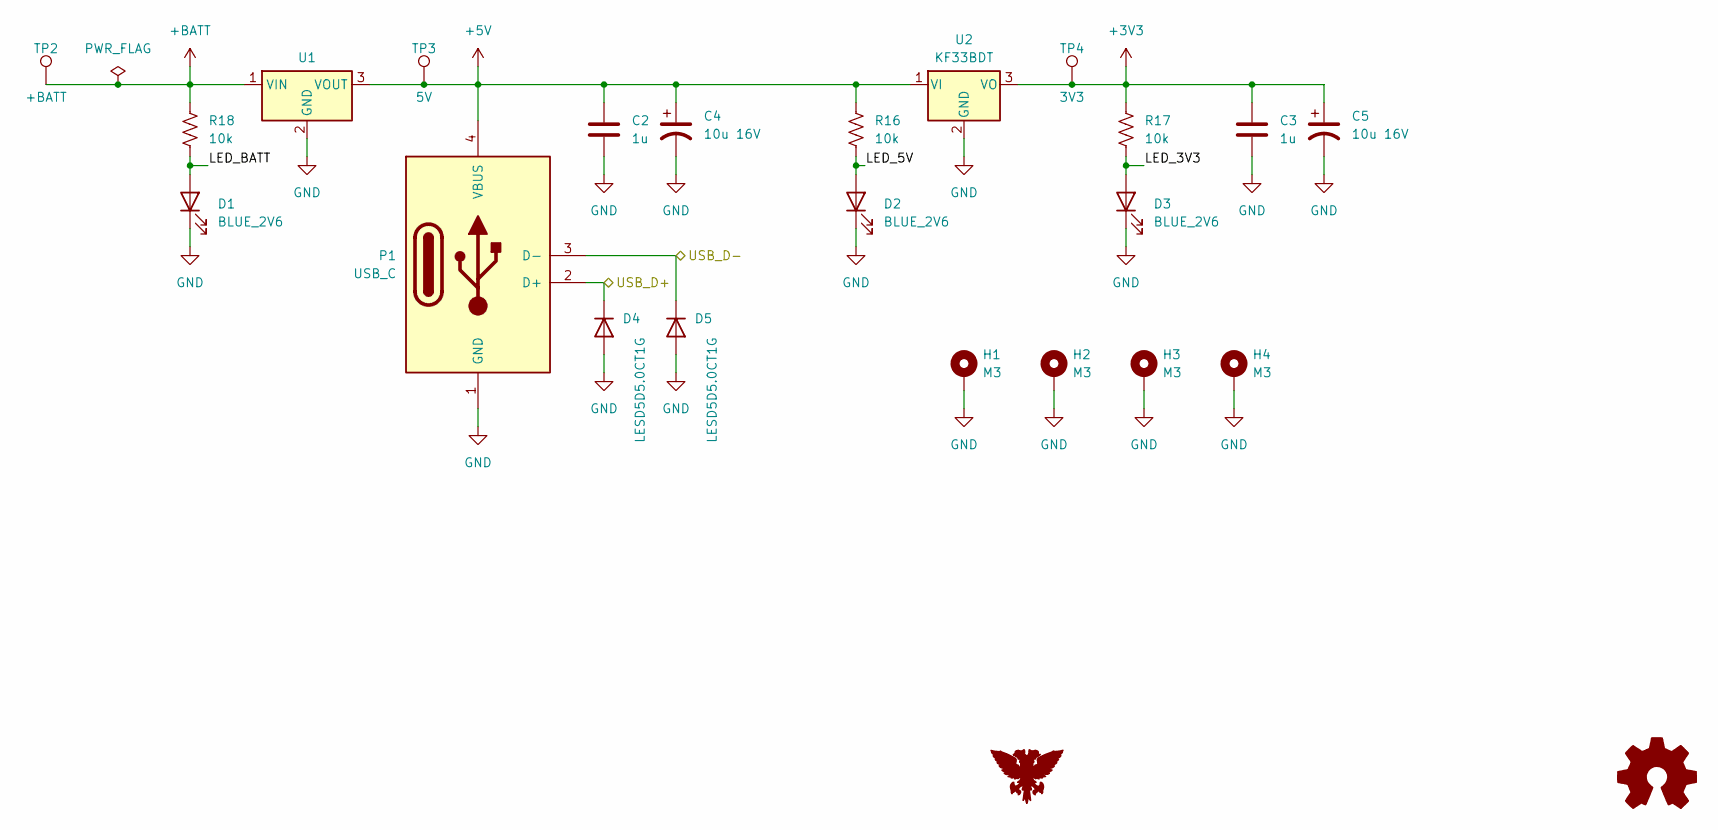
[picture p21: schematic power.kicad_sch]

Parts:
C2, C3: 1u; C_0805_2012Metric_Pad1.18x1.45mm_HandSolder
C4, C5: 10u 16V; CP_Radial_D5.0mm_P2.00mm
D1, D2, D3: BLUE_2V6; LED_0805_2012Metric_Pad1.15x1.40mm_HandSolder
D4, D5: LESD5D5.0CT1G; D_0805_2012Metric_Pad1.15x1.40mm_HandSolder
H1, H2, H3, H4: M3; MountingHole_3.2mm_M3_Pad_Via
P1: USB_C; Connector_USB-C
R16, R17, R18: 10k; R_0805_2012Metric_Pad1.20x1.40mm_HandSolder
TP2: +BATT; TestPoint_Pad_D1.0mm
TP3: 5V; TestPoint_Pad_D1.0mm
TP4: 3V3; TestPoint_Pad_D1.0mm
U1: Regulator_DC-DC_MINI-360
U2: KF33BDT; Regulator_KF33BD-TR

Connections:
+3V3: C3.1, C5.1, R17.1, TP4.1 (1_1), U2.3 (VO); also elsewhere on the board
+5V: C2.1, C4.1, P1.4 (VBUS), R16.1, TP3.1 (1_1), U1.3 (VOUT), U2.1 (VI); also elsewhere on the board
+BATT: R18.1, TP2.1 (1_1), U1.1 (VIN)
/power/LED_3V3: D3.2 (A), R17.2
/power/LED_5V: D2.2 (A), R16.2
/power/LED_BATT: D1.2 (A), R18.2
/power/USB_D+: D4.1 (K), P1.2 (D+); also elsewhere on the board
/power/USB_D-: D5.1 (K), P1.3 (D-); also elsewhere on the board
GND: C2.2, C3.2, C4.2, C5.2, D1.1 (K), D2.1 (K), D3.1 (K), D4.2 (A), D5.2 (A), H1.1 (1_1), H2.1 (1_1), H3.1 (1_1), H4.1 (1_1), P1.1 (GND), U1.2 (GND), U2.2 (GND); also elsewhere on the board

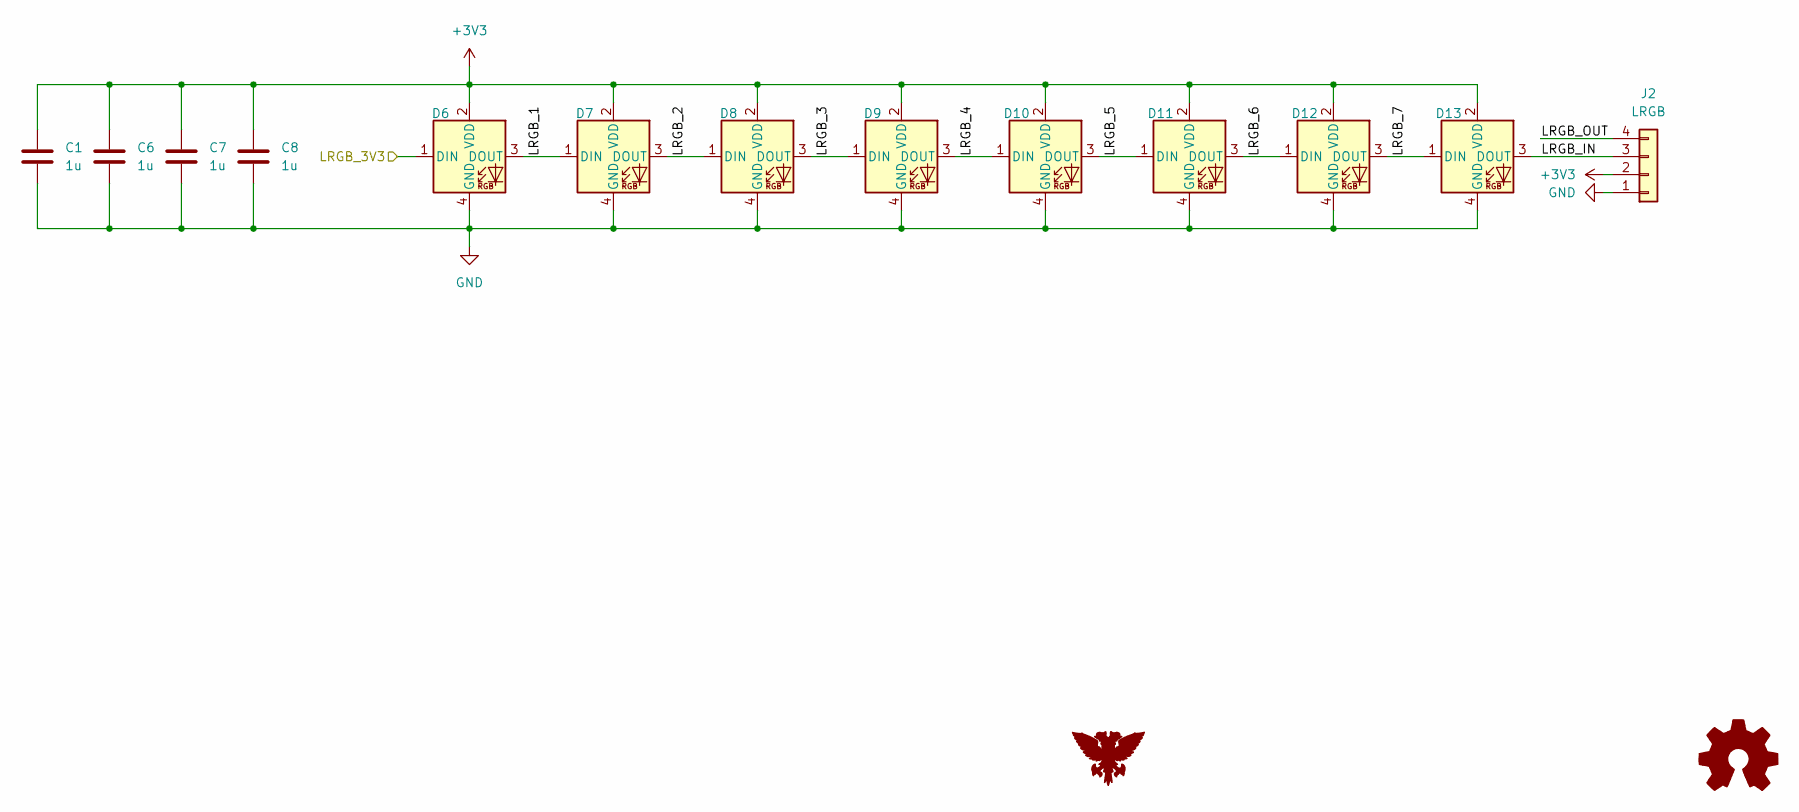
[picture p22: schematic led.kicad_sch]

Parts:
C1, C6, C7, C8: 1u; C_0805_2012Metric_Pad1.18x1.45mm_HandSolder
D6, D7, D8, D9, D10, D11, D12, D13: WS2812B-4020-G1; LED_WS2812B-4020
J2: LRGB; Connector_JST_ZH_B4B-ZR_1x04_P1.50mm_Vertical

Connections:
+3V3: C1.1, C6.1, C7.1, C8.1, D6.2 (VDD), D7.2 (VDD), D8.2 (VDD), D9.2 (VDD), D10.2 (VDD), D11.2 (VDD), D12.2 (VDD), D13.2 (VDD), J2.2; also elsewhere on the board
/led/LRGB_1: D6.3 (DOUT), D7.1 (DIN)
/led/LRGB_2: D7.3 (DOUT), D8.1 (DIN)
/led/LRGB_3: D8.3 (DOUT), D9.1 (DIN)
/led/LRGB_3V3: D6.1 (DIN); also elsewhere on the board
/led/LRGB_4: D9.3 (DOUT), D10.1 (DIN)
/led/LRGB_5: D10.3 (DOUT), D11.1 (DIN)
/led/LRGB_6: D11.3 (DOUT), D12.1 (DIN)
/led/LRGB_7: D12.3 (DOUT), D13.1 (DIN)
/led/LRGB_IN: D13.3 (DOUT), J2.3
/led/LRGB_OUT: J2.4
GND: C1.2, C6.2, C7.2, C8.2, D6.4 (GND), D7.4 (GND), D8.4 (GND), D9.4 (GND), D10.4 (GND), D11.4 (GND), D12.4 (GND), D13.4 (GND), J2.1; also elsewhere on the board

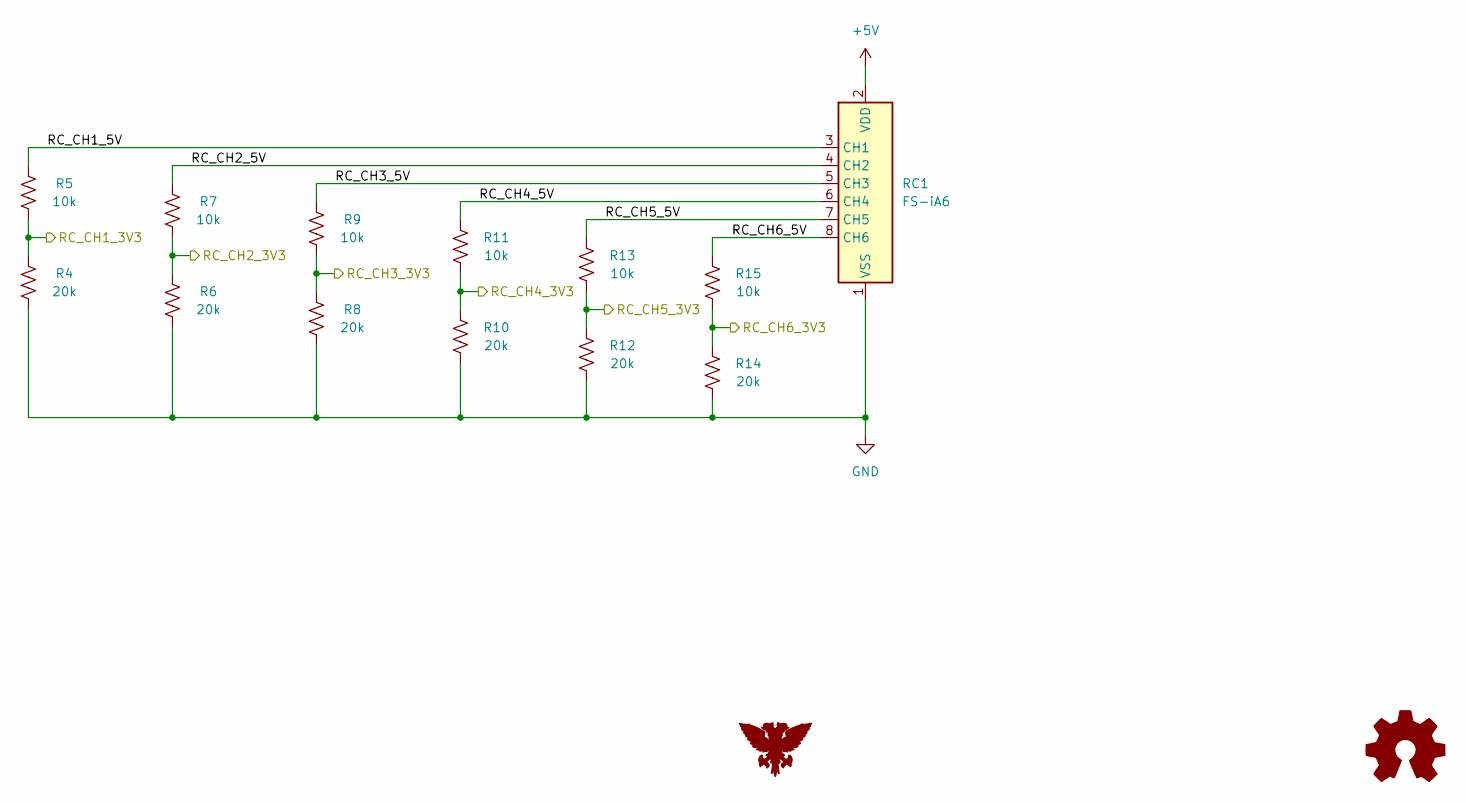
[picture p23: schematic radio.kicad_sch]

Parts:
R4, R6, R8, R10, R12, R14: 20k; R_0805_2012Metric_Pad1.20x1.40mm_HandSolder
R5, R7, R9, R11, R13, R15: 10k; R_0805_2012Metric_Pad1.20x1.40mm_HandSolder
RC1: FS-iA6; Receiver_FS-iA6

Connections:
+5V: RC1.2 (VDD); also elsewhere on the board
/processor/RC_CH1_3V3: R4.2, R5.1; also elsewhere on the board
/processor/RC_CH2_3V3: R6.2, R7.1; also elsewhere on the board
/processor/RC_CH3_3V3: R8.2, R9.1; also elsewhere on the board
/processor/RC_CH4_3V3: R10.2, R11.1; also elsewhere on the board
/processor/RC_CH5_3V3: R12.2, R13.1; also elsewhere on the board
/processor/RC_CH6_3V3: R14.2, R15.1; also elsewhere on the board
/radio/RC_CH1_5V: R5.2, RC1.3 (CH1)
/radio/RC_CH2_5V: R7.2, RC1.4 (CH2)
/radio/RC_CH3_5V: R9.2, RC1.5 (CH3)
/radio/RC_CH4_5V: R11.2, RC1.6 (CH4)
/radio/RC_CH5_5V: R13.2, RC1.7 (CH5)
/radio/RC_CH6_5V: R15.2, RC1.8 (CH6)
GND: R4.1, R6.1, R8.1, R10.1, R12.1, R14.1, RC1.1 (VSS); also elsewhere on the board

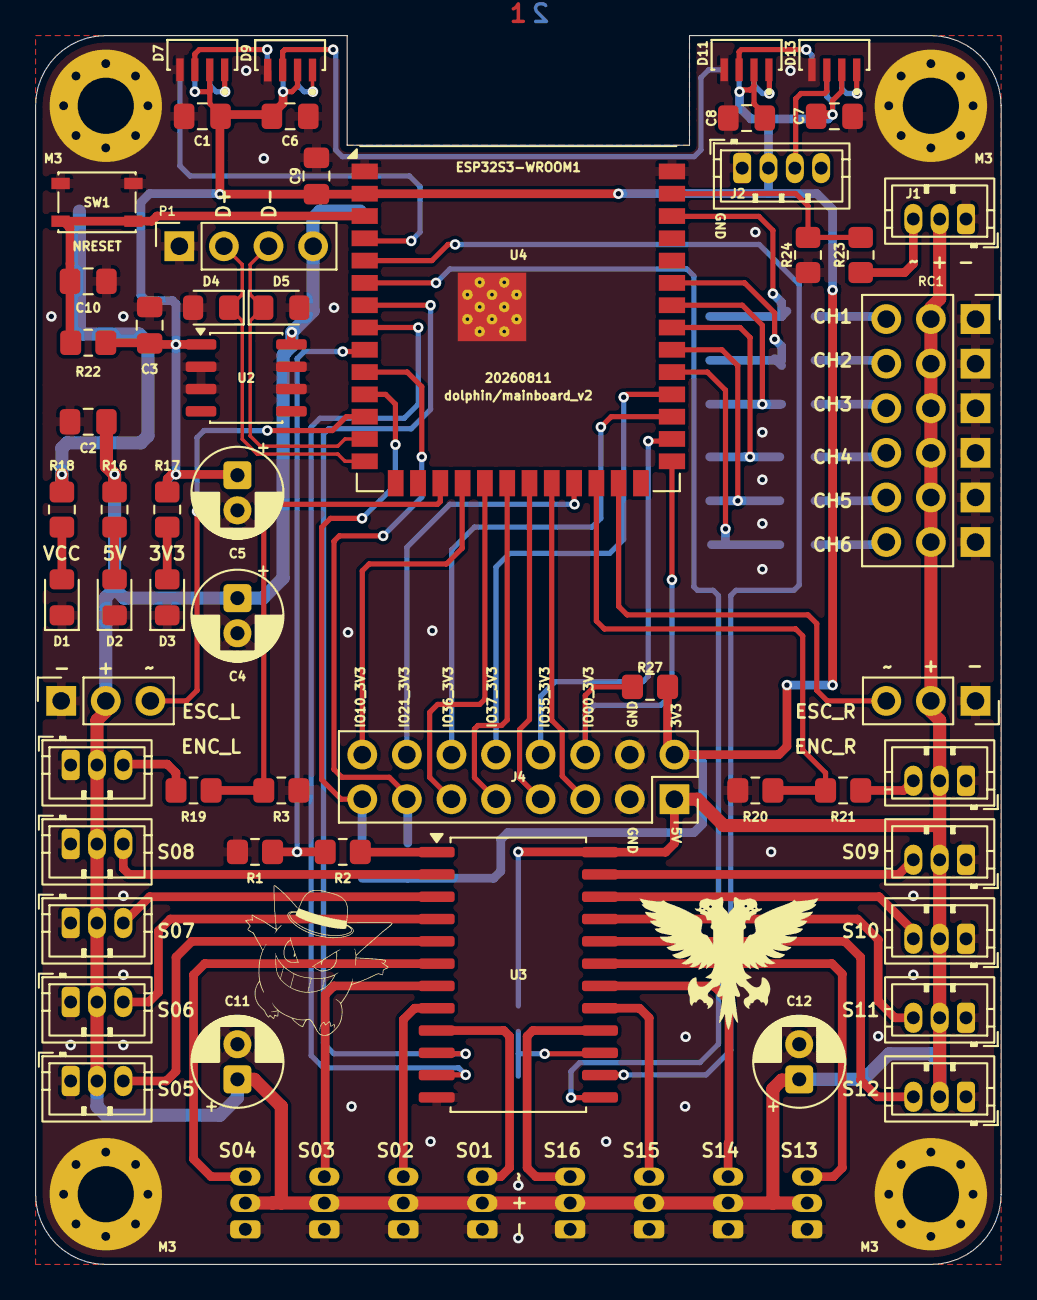
[picture p24: board mainboard.kicad_pcb from above]

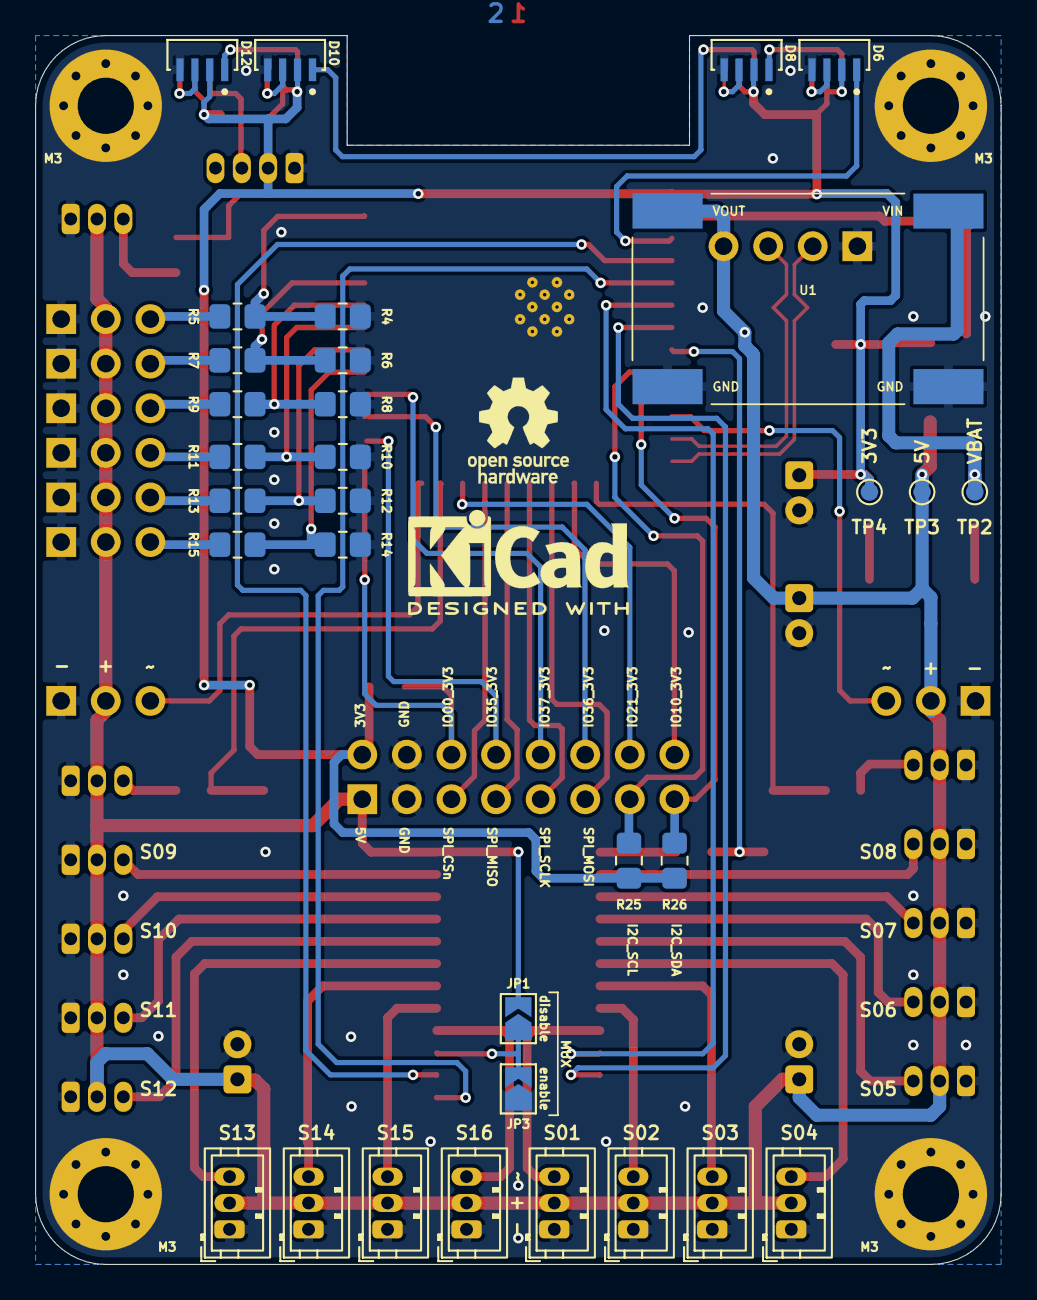
[picture p25: board mainboard.kicad_pcb from below]

Board: 2 copper layers, 55.0 x 70.0 mm, 91 parts (32 on the bottom side), 74 nets.
