tr0fin0/dolphin/hardware/projects/encoder/encoder.kicad_pcb

## KiCad design hardware/projects/encoder/encoder.kicad_pcb (2026-08-26)

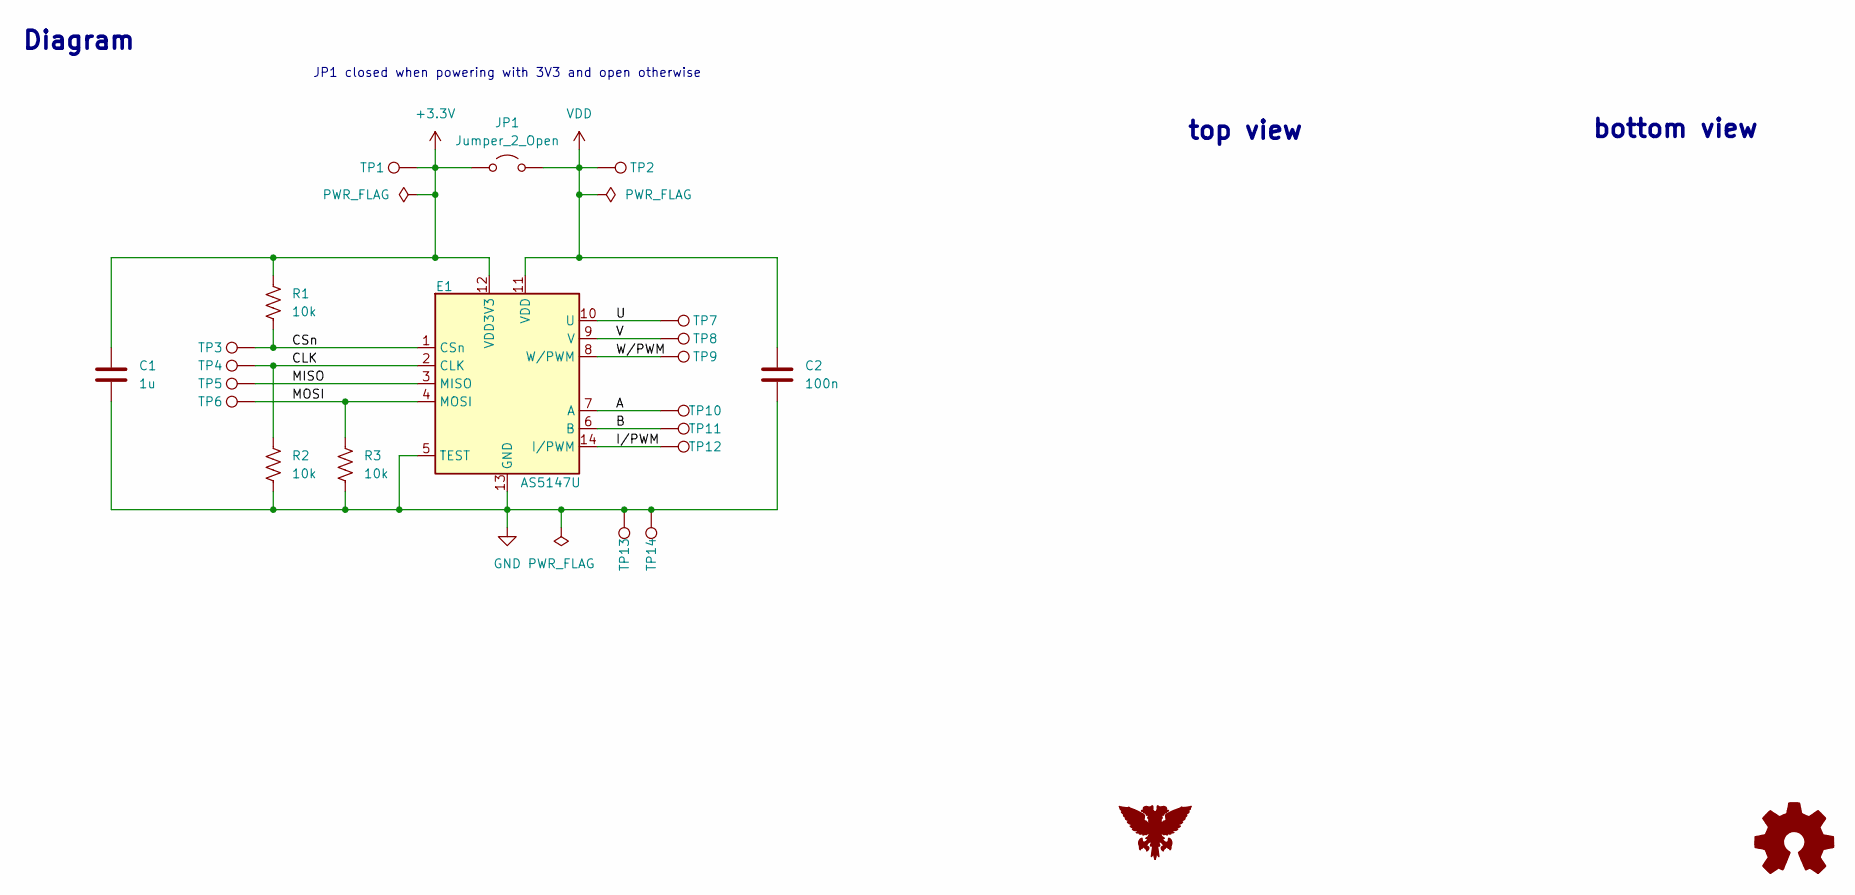
[picture p26: schematic encoder.kicad_sch]

Parts:
C1: 1u; C_0805_2012Metric_Pad1.18x1.45mm_HandSolder
C2: 100n; C_0805_2012Metric_Pad1.18x1.45mm_HandSolder
E1: AS5147U; Encoder_AS5147U
JP1: Jumper_2_Open; SolderJumper-2_P1.3mm_Open_TrianglePad1.0x1.5mm
R1, R2, R3: 10k; R_0805_2012Metric_Pad1.20x1.40mm_HandSolder
TP1, TP2, TP3, TP4, TP5, TP6, TP7, TP8, TP9, TP10, TP11, TP12, TP13, TP14: TestPoint; TestPoint_Pad_D1.0mm

Connections:
+3.3V: C1.2, E1.12 (VDD3V3), JP1.1 (A), R1.1, TP1.1 (1_1)
/A: E1.7 (A), TP10.1 (1_1)
/B: E1.6 (B), TP11.1 (1_1)
/CLK: E1.2 (CLK), R2.1, TP4.1 (1_1)
/CSn: E1.1 (CSn), R1.2, TP3.1 (1_1)
/I/PWM: E1.14 (I/PWM), TP12.1 (1_1)
/MISO: E1.3 (MISO), TP5.1 (1_1)
/MOSI: E1.4 (MOSI), R3.1, TP6.1 (1_1)
/U: E1.10 (U), TP7.1 (1_1)
/V: E1.9 (V), TP8.1 (1_1)
/W/PWM: E1.8 (W/PWM), TP9.1 (1_1)
GND: C1.1, C2.1, E1.5 (TEST), E1.13 (GND), R2.2, R3.2, TP13.1 (1_1), TP14.1 (1_1)
VDD: C2.2, E1.11 (VDD), JP1.2 (B), TP2.1 (1_1)

Notes on the sheet:
Diagram
JP1 closed when powering with 3V3 and open otherwise
top view
bottom view

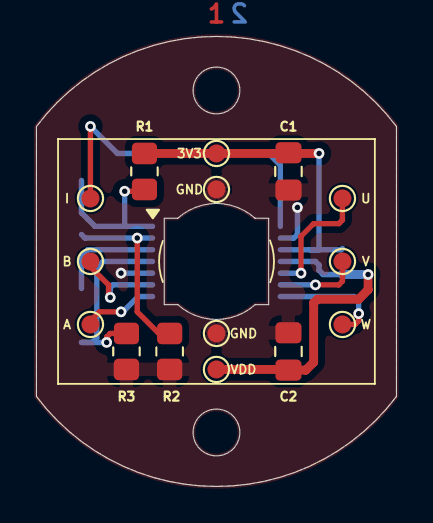
[picture p27: board encoder.kicad_pcb from above]

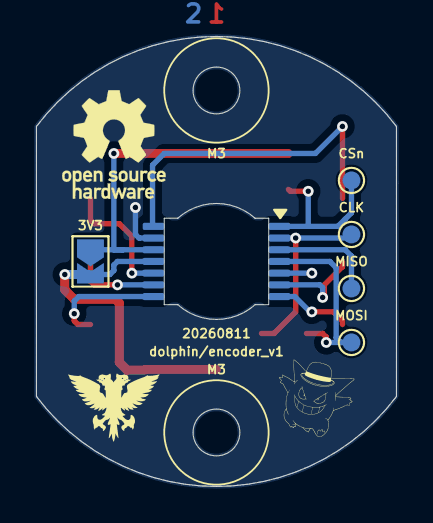
[picture p28: board encoder.kicad_pcb from below]

Board: 2 copper layers, 20.0 x 25.0 mm, 21 parts (5 on the bottom side), 13 nets.
