tr0fin0/dolphin/hardware/projects/line/line.kicad_pcb

## KiCad design hardware/projects/line/line.kicad_pcb (2026-08-26)

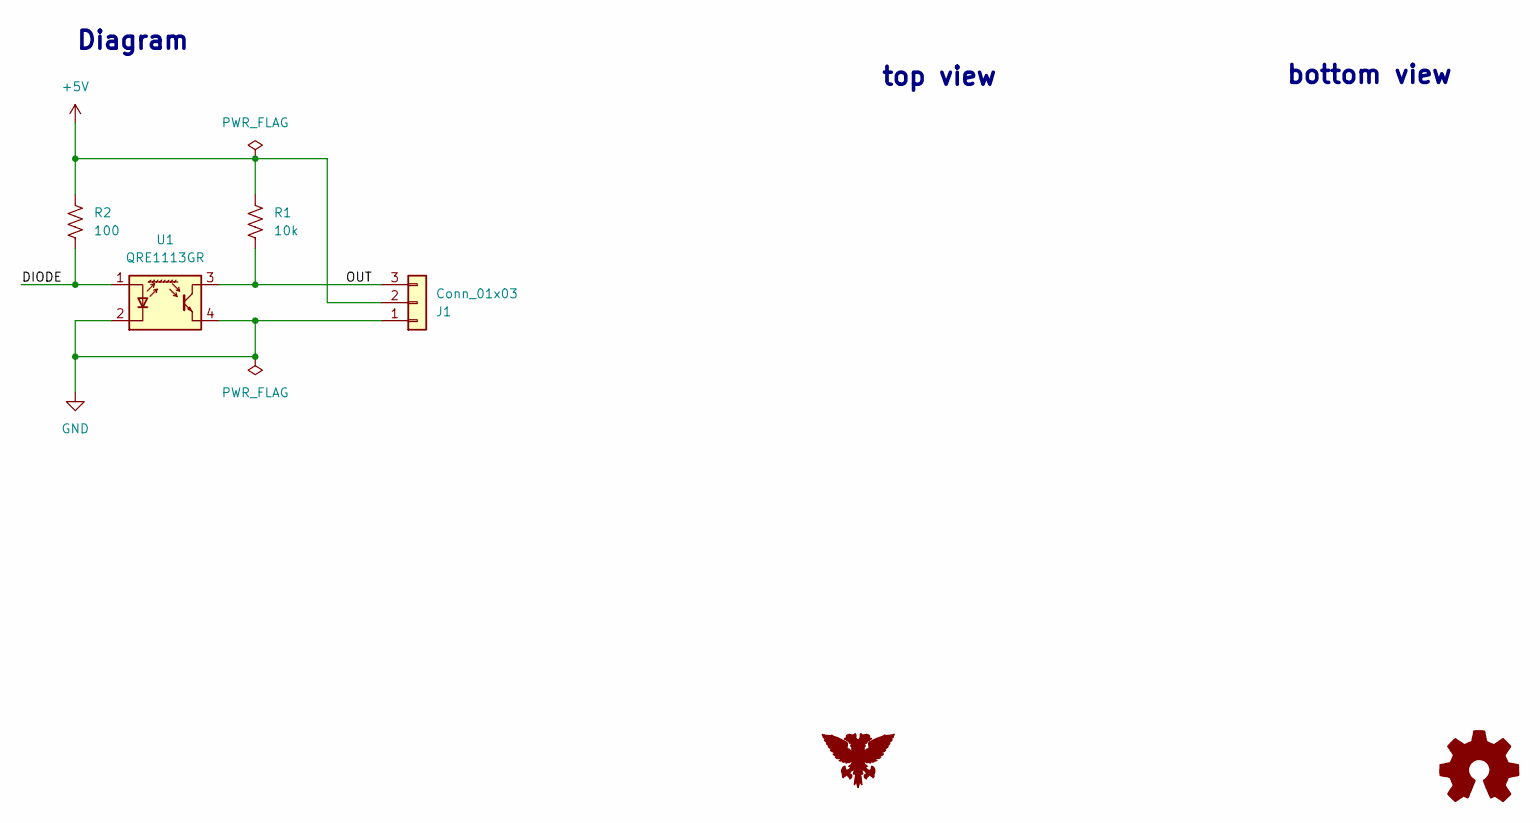
[picture p29: schematic line.kicad_sch]

Parts:
J1: Conn_01x03; PinHeader_1x03_P2.54mm_Vertical
R1: 10k; R_0805_2012Metric_Pad1.20x1.40mm_HandSolder
R2: 100; R_0805_2012Metric_Pad1.20x1.40mm_HandSolder
U1: QRE1113GR; OnSemi_CASE100CY

Connections:
+5V: J1.2, R1.1, R2.1
/DIODE: R2.2, U1.1 (A)
/OUT: J1.3, R1.2, U1.3
GND: J1.1, U1.2 (K), U1.4

Notes on the sheet:
bottom view
top view
Diagram

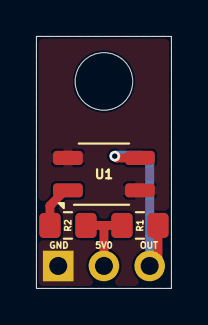
[picture p30: board line.kicad_pcb from above]

Board: 2 copper layers, 7.5 x 14.0 mm, 4 parts (0 on the bottom side), 4 nets.
