tr0fin0/dolphin/components/fsm/states/src/opening.c

#include "config.h"
#include "esc.h"
#include "fsm.h"
#include "logging.h"
#include "opening.h"
#include "pwm.h"
#include "radio.h"

static opening_t opening_strategy;
static pwm_norm_t button_us = 0;

uint8_t opening_step = 0;

void opening_entry(void) {
    button_us = radio_read_channel(RADIO_CHANNEL_3);
}

void opening_run(void) {
    if (radio_get_status() == RADIO_DISCONNECTED) {
        fsm_transition(STATE_SAFE);

        return;
    }

    pwm_norm_t pulses_us[NUMBER_OF_RADIO_CHANNELS];
    radio_read_channels(pulses_us);

    // ensure initial button value is not PWM_NEUTRAL_US
    if (
        button_us == PWM_NEUTRAL_US &&
        pulses_us[RADIO_CHANNEL_3] != PWM_NEUTRAL_US
    ) {
        button_us = pulses_us[RADIO_CHANNEL_3];
    }

    if (
        opening_step < OPENING_ITERATIONS &&
        button_us != pulses_us[RADIO_CHANNEL_3]
    ) {
        // opening selection
        button_us = pulses_us[RADIO_CHANNEL_3];

        uint8_t increase;
        if (
            pulses_us[RADIO_CHANNEL_2] > (PWM_NEUTRAL_US + PWM_MAXIMUM_US) / 2
        ) {
            increase = 2;
        } else if (
            pulses_us[RADIO_CHANNEL_2] < (PWM_NEUTRAL_US + PWM_MINIMUM_US) / 2
        ) {
            increase = 1;
        } else {
            increase = 0;
        }

        opening_strategy = (opening_t)(10 * opening_strategy + increase);
        LOG_W("current opening strategy is %d", opening_strategy);

        led_set_toggle(LED_STATE, 100);
        opening_step++;
    } else if (
        opening_step == OPENING_ITERATIONS &&
        button_us != pulses_us[RADIO_CHANNEL_3]
    ) {
        // opening execution
        button_us = pulses_us[RADIO_CHANNEL_3];
        LOG_W("running opening strategy %d", opening_strategy);

        switch (opening_strategy) {
            case OPENING_STATIC:
                break;

            case OPENING_DRAW:
                // rotation     +180
                // esc_set_pwm(pwm_percentage(+90), ESC_L);
                // esc_set_pwm(pwm_percentage(+90), ESC_R);
                // // delay(80);
                // esc_set_pwm_mix_neutral();
                // // delay(1);

                break;

            case OPENING_NE:
                // rotation     +045
                // esc_set_pwm(pwm_percentage(+90), ESC_L);
                // esc_set_pwm(pwm_percentage(+90), ESC_R);
                // // delay(25);
                // esc_set_pwm_mix_neutral();
                // // delay(1);

                // translation  +50
                // esc_set_pwm(pwm_percentage(+90), ESC_L);
                // esc_set_pwm(pwm_percentage(-90), ESC_R);
                // // delay(140);
                // esc_set_pwm_mix_neutral();
                // // delay(1);

                // rotation     -090
                // esc_set_pwm(pwm_percentage(-90), ESC_L);
                // esc_set_pwm(pwm_percentage(-90), ESC_R);
                // // delay(65);
                // esc_set_pwm_mix_neutral();
                // // delay(1);

                break;

            case OPENING_NN:
                // translation  +50
                // esc_set_pwm(pwm_percentage(+90), ESC_L);
                // esc_set_pwm(pwm_percentage(-90), ESC_R);
                // // delay(140);
                // esc_set_pwm_mix_neutral();
                // // delay(1);

                break;

            case OPENING_NW:
                // rotation     -045
                // esc_set_pwm(pwm_percentage(-90), ESC_L);
                // esc_set_pwm(pwm_percentage(-90), ESC_R);
                // // delay(25);
                // esc_set_pwm_mix_neutral();
                // // delay(1);

                // translation  +50
                // esc_set_pwm(pwm_percentage(+90), ESC_L);
                // esc_set_pwm(pwm_percentage(-90), ESC_R);
                // // delay(140);
                // esc_set_pwm_mix_neutral();
                // // delay(1);

                // rotation     +090
                // esc_set_pwm(pwm_percentage(+90), ESC_L);
                // esc_set_pwm(pwm_percentage(+90), ESC_R);
                // // delay(65);
                // esc_set_pwm_mix_neutral();
                // // delay(1);

                break;

            case OPENING_SE:
                // rotation     -045
                // esc_set_pwm(pwm_percentage(-90), ESC_L);
                // esc_set_pwm(pwm_percentage(-90), ESC_R);
                // // delay(30);
                // esc_set_pwm_mix_neutral();
                // // delay(1);

                // translation  -50
                // esc_set_pwm(pwm_percentage(-90), ESC_L);
                // esc_set_pwm(pwm_percentage(+90), ESC_R);
                // // delay(120);
                // esc_set_pwm_mix_neutral();
                // // delay(1);

                // rotation     +090
                // esc_set_pwm(pwm_percentage(+90), ESC_L);
                // esc_set_pwm(pwm_percentage(+90), ESC_R);
                // // delay(60);
                // esc_set_pwm_mix_neutral();
                // // delay(1);

                break;

            case OPENING_SEN:
                // rotation     -045
                // esc_set_pwm(pwm_percentage(-90), ESC_L);
                // esc_set_pwm(pwm_percentage(-90), ESC_R);
                // // delay(30);
                // esc_set_pwm_mix_neutral();
                // // delay(1);

                // translation  -50
                // esc_set_pwm(pwm_percentage(-90), ESC_L);
                // esc_set_pwm(pwm_percentage(+90), ESC_R);
                // // delay(120);
                // esc_set_pwm_mix_neutral();
                // // delay(1);

                break;

            case OPENING_SS:
                // translation  -50
                // esc_set_pwm(pwm_percentage(-90), ESC_L);
                // esc_set_pwm(pwm_percentage(+90), ESC_R);
                // // delay(120);
                // esc_set_pwm_mix_neutral();
                // // delay(1);

                break;

            case OPENING_SW:
                // rotation     +045
                // esc_set_pwm(pwm_percentage(+90), ESC_L);
                // esc_set_pwm(pwm_percentage(+90), ESC_R);
                // // delay(30);
                // esc_set_pwm_mix_neutral();
                // // delay(1);

                // translation  -50
                // esc_set_pwm(pwm_percentage(-90), ESC_L);
                // esc_set_pwm(pwm_percentage(+90), ESC_R);
                // // delay(120);
                // esc_set_pwm_mix_neutral();
                // // delay(1);

                // rotation     -090
                // esc_set_pwm(pwm_percentage(-90), ESC_L);
                // esc_set_pwm(pwm_percentage(-90), ESC_R);
                // // delay(60);
                // esc_set_pwm_mix_neutral();
                // // delay(1);

                break;

            case OPENING_SWN:
                // rotation     +045
                // esc_set_pwm(pwm_percentage(+90), ESC_L);
                // esc_set_pwm(pwm_percentage(+90), ESC_R);
                // // delay(20);
                // esc_set_pwm_mix_neutral();
                // // delay(1);

                // translation  -50
                // esc_set_pwm(pwm_percentage(-90), ESC_L);
                // esc_set_pwm(pwm_percentage(+90), ESC_R);
                // // delay(120);
                // esc_set_pwm_mix_neutral();
                // // delay(1);

                break;
        }

        fsm_transition(STATE_MANUAL);
    }
}
