tr0fin0/dolphin/components/fsm/states/include/manual.h

/**
 * @file manual.h
 * @brief STATE_MANUAL definition of the FSM callback functions `on_exit()`
 * and `on_run()`.
 *
 * @author Guilherme Nunes Trofino
 * @date 2026-05-13
 */

#pragma once

/**
 * @brief Exit handler for @ref STATE_MANUAL.
 *
 * Ensures both motors are driven to @ref PWM_NEUTRAL_US, preventing unintended
 * motion during transition.
 */
void manual_exit(void);

/**
 * @brief Run handler for @ref STATE_MANUAL.
 *
 * While the Radio Controller is connected, reads the steering and throttle
 * channels and forwards them to the motor controllers.
 *
 * @note Transition to @ref STATE_SAFE if the Radio Controller is disconnected.
 */
void manual_run(void);
