tr0fin0/dolphin/components/fsm/states/src/attack.c

#include "attack.h"
#include "esc.h"
#include "fsm.h"
#include "radio.h"

void attack_exit(void) {
    esc_set_pwm_mix_neutral();
}

void attack_run(void) {
    if (radio_get_status() != RADIO_CONNECTED) {
        fsm_transition(STATE_SAFE);

        return;
    }
}
