tr0fin0/dolphin/(commit log)

2026-05-16 refactor: creation of proprietary RGB LED controller (#59)
2026-05-24 ci(fix): path condition trigger to platformio workflow (#65)
    [esc.h, led.h, opening.c, opening.h, pwm.h, radio.h]
2026-08-19 fix(docs): firmware doxygen formatting (#97)
    [attack.h, boot.h, esc.c, esc.h, led.h]
2026-08-26 feat!: add KiCAD projects (#95)
    [encoder.csv, encoder.kicad_pcb, encoder.kicad_sch, encoder.step, led.kicad_sch, line.csv, line.kicad_pcb, line.kicad_sch]
2026-09-03 refactor!: pin_t to enumerate (#118)
    pin numbers now match the KiCAD boards already present on the repository.
2026-09-10 fix: radio.c ISR initialization condition (#130)
    [radio.c]
2026-09-11 refactor: LED defined variables to enum (#124)
2026-09-11 refactor: led_strip depency to IDF Component Manager (#123)
2026-09-11 refactor: pwm.h remove percentage definitions (#126)
2026-09-23 feat: add sensor component (#120)
